suxing304/atrias/software/atrias/scripts/README

Scripts bag2mat.py and load_bag.py were copied from starmac_tools revision 293.
