suxing304/atrias/hardware/menial_board_v2.1/parts_list.xls

Quantity | Distributer | Distributer Part Number | Manufacturer Part Number | Ref. Des. | Description | Manufacturer
11 | Digikey | WM18920-ND | 353620250 | E-IN E-OUT LOGIC SW1-8 | CONN HEADER 2POS 2MM VERT TIN | MOLEX INC
3 | Digikey | WM18922-ND | 353620450 | AUX1-3 | CONN HEADER 4POS 2MM VERT TIN | MOLEX INC
2 | Digikey | WM18923-ND | 353620550 | HALL RGB_LED | CONN HEADER 5POS 2MM VERT TIN | MOLEX INC
3 | Digikey | WM18924-ND | 353620650 | SSI_BISS1-3 | CONN HEADER 6POS 2MM VERT TIN | MOLEX INC
3 | Digikey | WM18926-ND | 353620850 | INC_ENCODER STRAIN THERMISTOR | CONN HEADER 8POS 2MM VERT TIN | MOLEX INC
1 | Digikey | WM18586-ND | 87831-2220 | AMP_CONN | CONN HEADER 22POS 2MM VERT GOLD | MOLEX CONNECTOR CORPORATION
1 | Digikey | SW1015-ND | A6S-6104-H | DIP_SWITCH | SWITCH DIP 6POS TOP ACT GULLEAD | OMRON ELECTRONICS INC-EMC DIV
2 | Digikey | ADG3308BRUZ-ND | ADG3308BRUZ | U7 U12 | IC XLATOR 8CH 1.2-5.5V 20-TSSOP | ANALOG DEVICES INC
3 | Digikey | ADM3490ARZ-ND | ADM3490ARZ | U3-5 | IC TXRX RS-422/485 3.3V 8-SOIC | ANALOG DEVICES INC
1 | Digikey | ADN4668ARUZ-ND | ADN4668ARUZ | U6 | IC RCVR LVDS DIFF 4CH 16TSSOP | ANALOG DEVICES INC
12 | Digikey | 399-1100-1-ND | C0603C104Z3VACTU | C7-12 C17-19 C25-27 | CAP CER 0.1UF 25V Y5V 0603 | KEMET (VA)
6 | Digikey | 445-5062-1-ND | C1608C0G1H131J | C1-6 | CAP CER 130PF 50V 5% NP0 0603 | TDK CORPORATION (VA)
2 | Digikey | 445-5051-1-ND | C1608C0G1H160J | C15-16 | CAP CER 16PF 50V 5% NP0 0603 | TDK CORPORATION (VA)
2 | Digikey | 445-1313-1-ND | C1608X7R1H473K080AA | C22-23 | CAP CER 0.047UF 50V 10% X7R 0603 | TDK CORPORATION (VA)
1 | Digikey | P5850-ND | ECA-2AHG471 | C24 | CAP ALUM 470UF 100V 20% RADIAL | PANASONIC ELECTRONIC COMPONENTS
3 | Digikey | Z2101-ND | G3VM-61D1 | U1-2 U8 | RELAY SSR SPST 60V 500MA 4SMT | OMRON ELECTRONICS INC-EMC DIV
1 | Digikey | 390-1125-5-ND | IL3122-3E | U10 | TXRX ISO BUS 5MBPS RS422 16SOIC | NVE CORP/ISOLATION PRODUCTS
1 | Digikey | ED1762-ND | EDZ1110/5 | MOTOR_POWER | TERM BLOCK PLUG 5.08MM 5POS | ON SHORE TECHNOLOGY INC
1 | Digikey | ED2846-ND | OSTOQ055450 | MOTOR_POWER | TERM BLOCK HDR 5.08MM 5POS PCB | ON SHORE TECHNOLOGY INC
2 | Digikey | P10GCT-ND | ERJ-3GEYJ100V | R22-23 | RES 10 OHM 1/10W 5% 0603 SMD | PANASONIC ELECTRONIC COMPONENTS (VA)
3 | Digikey | P10KGCT-ND | ERJ-3GEYJ103V | R9-11 R32 | RES 10K OHM 1/10W 5% 0603 SMD | PANASONIC ELECTRONIC COMPONENTS (VA)
1 | Digikey | P143KHCT-ND | ERJ-3EKF1433V | R26 | RES 143K OHM 1/10W 1% 0603 SMD | PANASONIC ELECTRONIC COMPONENTS (VA)
5 | Digikey | P20KGCT-ND | ERJ-3GEYJ203V | R1-2 R12-14 R28 | RES 20K OHM 1/10W 5% 0603 SMD | PANASONIC ELECTRONIC COMPONENTS (VA)
8 | Digikey | P249HCT-ND | ERJ-3EKF2490V | R7-8 R15-20 | RES 249 OHM 1/10W 1% 0603 SMD | PANASONIC ELECTRONIC COMPONENTS (VA)
1 | Digikey | P3.74KHCT-ND | ERJ-3EKF3741V | R30 | RES 3.74K OHM 1/10W 1% 0603 SMD | PANASONIC ELECTRONIC COMPONENTS (VA)
10 | Digikey | P4.7KGCT-ND | ERJ-3GEYJ472V | R24-25 R40-47 | RES 4.7K OHM 1/10W 5% 0603 SMD | PANASONIC ELECTRONIC COMPONENTS (VA)
2 | Digikey | P510GCT-ND | ERJ-3GEYJ511V | R34 R36-37 R39 | RES 510 OHM 1/10W 5% 0603 SMD | PANASONIC ELECTRONIC COMPONENTS (VA)
3 | Digikey | P5.1KGCT-ND | ERJ-3GEYJ512V | R27 R29 | RES 5.1K OHM 1/10W 5% 0603 SMD | PANASONIC ELECTRONIC COMPONENTS (VA)
1 | Digikey | P68GCT-ND | ERJ-3GEYJ680V | R21 | RES 68 OHM 1/10W 5% 0603 SMD | PANASONIC ELECTRONIC COMPONENTS (VA)
2 | Digikey | P680GCT-ND | ERJ-3GEYJ681V | R31 R33 | RES 680 OHM 1/10W 5% 0603 SMD | PANASONIC ELECTRONIC COMPONENTS (VA)
2 | Digikey | P820GCT-ND | ERJ-3GEYJ821V | R35 R38 | RES 820 OHM 1/10W 5% 0603 SMD | PANASONIC ELECTRONIC COMPONENTS (VA)
1 | Digikey | 296-26358-1-ND | SN65LVDS049PWR | U13 | IC LVDS DUAL DIF DVR/RCV 16TSSOP | TEXAS INSTRUMENTS (VA)
1 | Digikey | P24.9KHCT-ND | ERJ-3EKF2492V |  | RES 24.9K OHM 1/10W 1% 0603 SMD | PANASONIC ELECTRONIC COMPONENTS (VA)
1 | Digikey | WM18051-ND | 51110-2251 | AMP_CONN | CONN HOUSING 2MM 22POS POLARIZED | MOLEX CONNECTOR CORPORATION
22 | Digikey | WM1128CT-ND | 503948051 | AMP_CONN | CONN TERM FEMALE 24-30AWG GOLD | MOLEX INC (VA)
11 | Digikey | WM5981-ND | 355070200 | E-IN E-OUT LOGIC SW1-8 | CONN RECEPTACLE HOUSING 2POS 2MM | MOLEX INC
3 | Digikey | WM5983-ND | 355070400 | AUX1-3 | CONN RECEPTACLE HOUSING 4POS 2MM | MOLEX INC
2 | Digikey | WM5984-ND | 35507-0500 | HALL RGB_LED | CONN RECEPTACLE HOUSING 5POS 2MM | MOLEX CONNECTOR CORPORATION
3 | Digikey | WM5985-ND | 355070600 | SSI_BISS1-3 | CONN RECEPTACLE HOUSING 6POS 2MM | MOLEX INC
3 | Digikey | WM5987-ND | 355070800 | INC_ENCODER STRAIN THERMISTOR | CONN RECEPTACLE HOUSING 8POS 2MM | MOLEX INC
86 | Digikey | WM6050-ND | 502128100 |  | CONN TERM FEMALE 24-30AWG TIN | MOLEX INC
2 | Samtec | SSM-112-L-DV-BE | SSM-112-L-DV-BE | DZRALTE_CONN | .100" (2,54 mm) Tiger Claw™ Surface Mount Socket Strip | Samtec
1 | Samtec | SSM-115-L-DV-BE | SSM-115-L-DV-BE | DZRALTE_CONN | .100" (2,54 mm) Tiger Claw™ Surface Mount Socket Strip | Samtec
