suxing304/atrias/hardware/amp_breakout_v1/BOM.ods

Quantity: | Reference ID: | Digikey Part:
1 | J2 | WM18586-ND
1 | C24 | P5850-ND
1 | J3 | ED2831-ND
1 | J3 | ED2869-ND
2 | R1-2 | P20KGCT-ND
2 | J1 | SAM1146-12-ND
1 | J1 | SAM1146-15-ND
