suxing304/atrias/documentation/ATRIAS_2.0_Amp_Stack.DXF

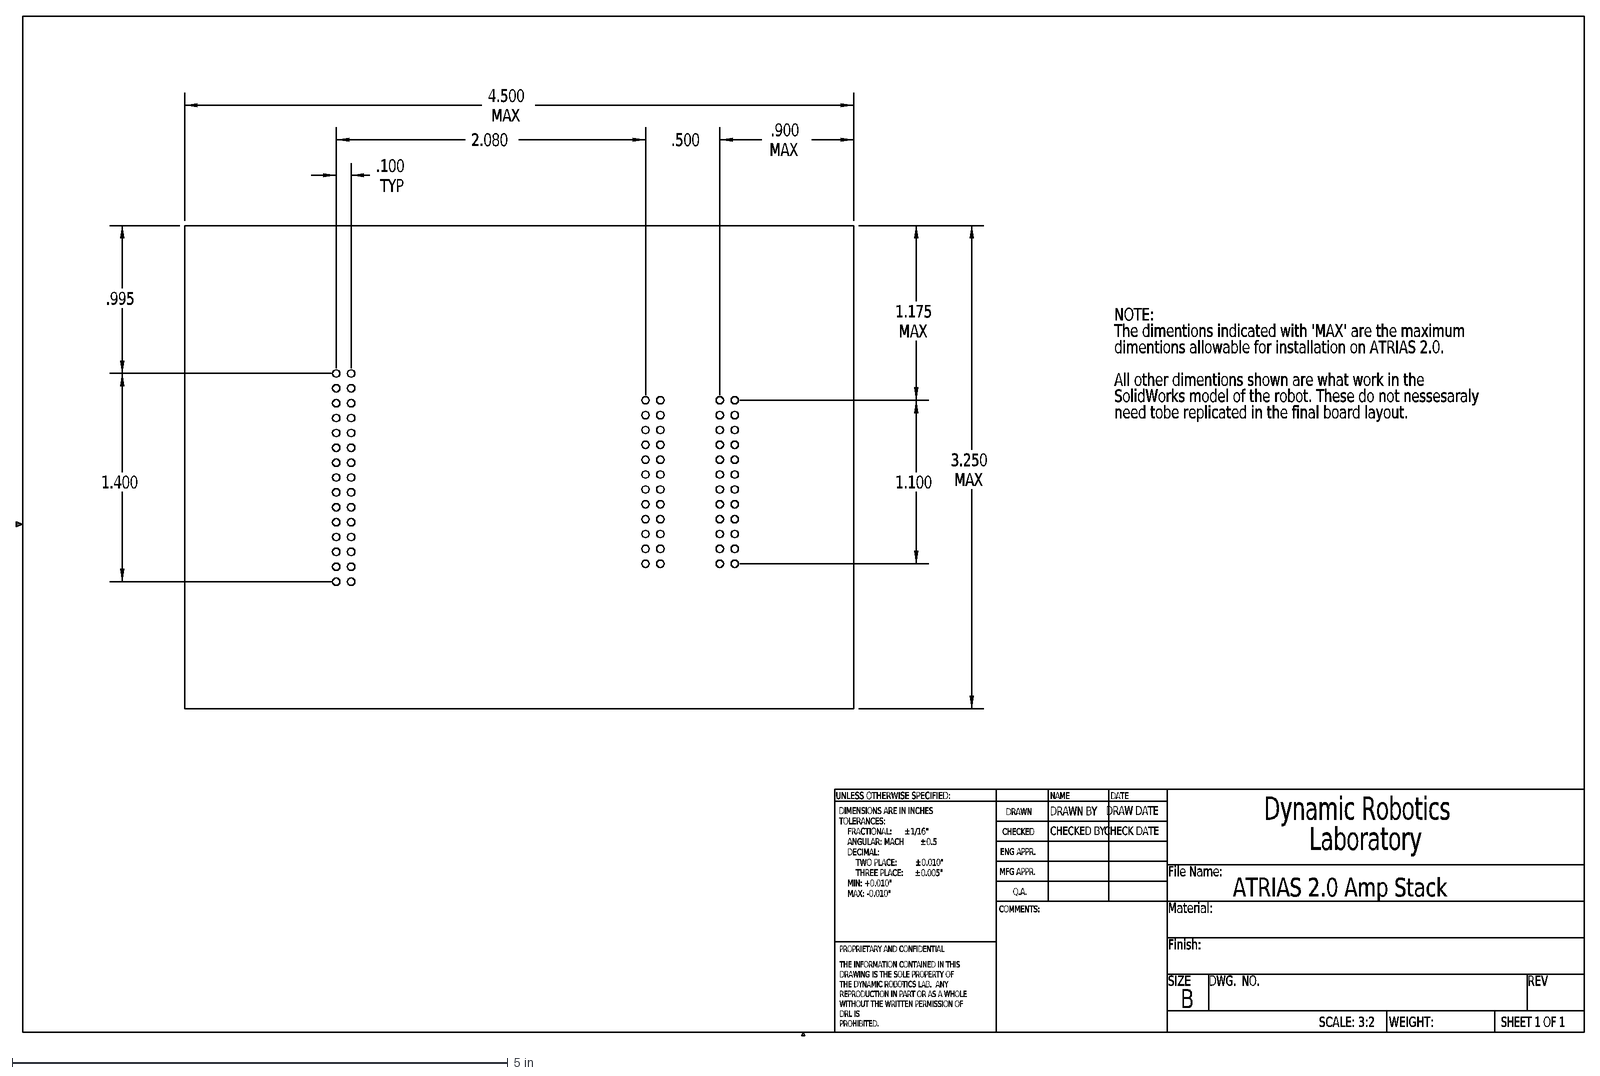
[picture p1: CAD file, 2012-02-10]
documentation/ATRIAS_2.0_Amp_Stack.DXF
NOTE:
The dimentions indicated with 'MAX' are the maximum
dimentions allowable for installation on ATRIAS 2.0.
All other dimentions shown are what work in the
SolidWorks model of the robot. These do not nessesaraly
need tobe replicated in the final board layout.
THE INFORMATION CONTAINED IN THIS
DRAWING IS THE SOLE PROPERTY OF
THE DYNAMIC ROBOTICS LAB. ANY
REPRODUCTION IN PART OR AS A WHOLE
WITHOUT THE WRITTEN PERMISSION OF
DRL IS
PROHIBITED.
PROPRIETARY AND CONFIDENTIAL
DIMENSIONS ARE IN INCHES
TOLERANCES:
FRACTIONAL:
±
1/16"
ANGULAR: MACH
0.5
DECIMAL:
TWO PLACE:
0.010"
THREE PLACE:
0.005"
MIN: +0.010"
MAX: -0.010"
DRAWN
CHECKED
ENG APPR.
MFG APPR.
Q.A.
COMMENTS:
DATE
NAME
SIZE
B
DWG. NO.
REV
WEIGHT:
UNLESS OTHERWISE SPECIFIED:
SHEET 1 OF 1
Material:
ATRIAS 2.0 Amp Stack
Finish:
DRAWN BY
DRAW DATE
SCALE: 3:2
File Name:
CHECKED BY
CHECK DATE
Dynamic Robotics
Laboratory
4.500
MAX
2.080
.500
.900
3.250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
