suxing304/atrias/hardware/strain_gauge_digitizer_v2.1/strain_gauge_digitizer_v2.1_sch.pdf

D

6 | 5 | 4 | 3 | 2 | 1

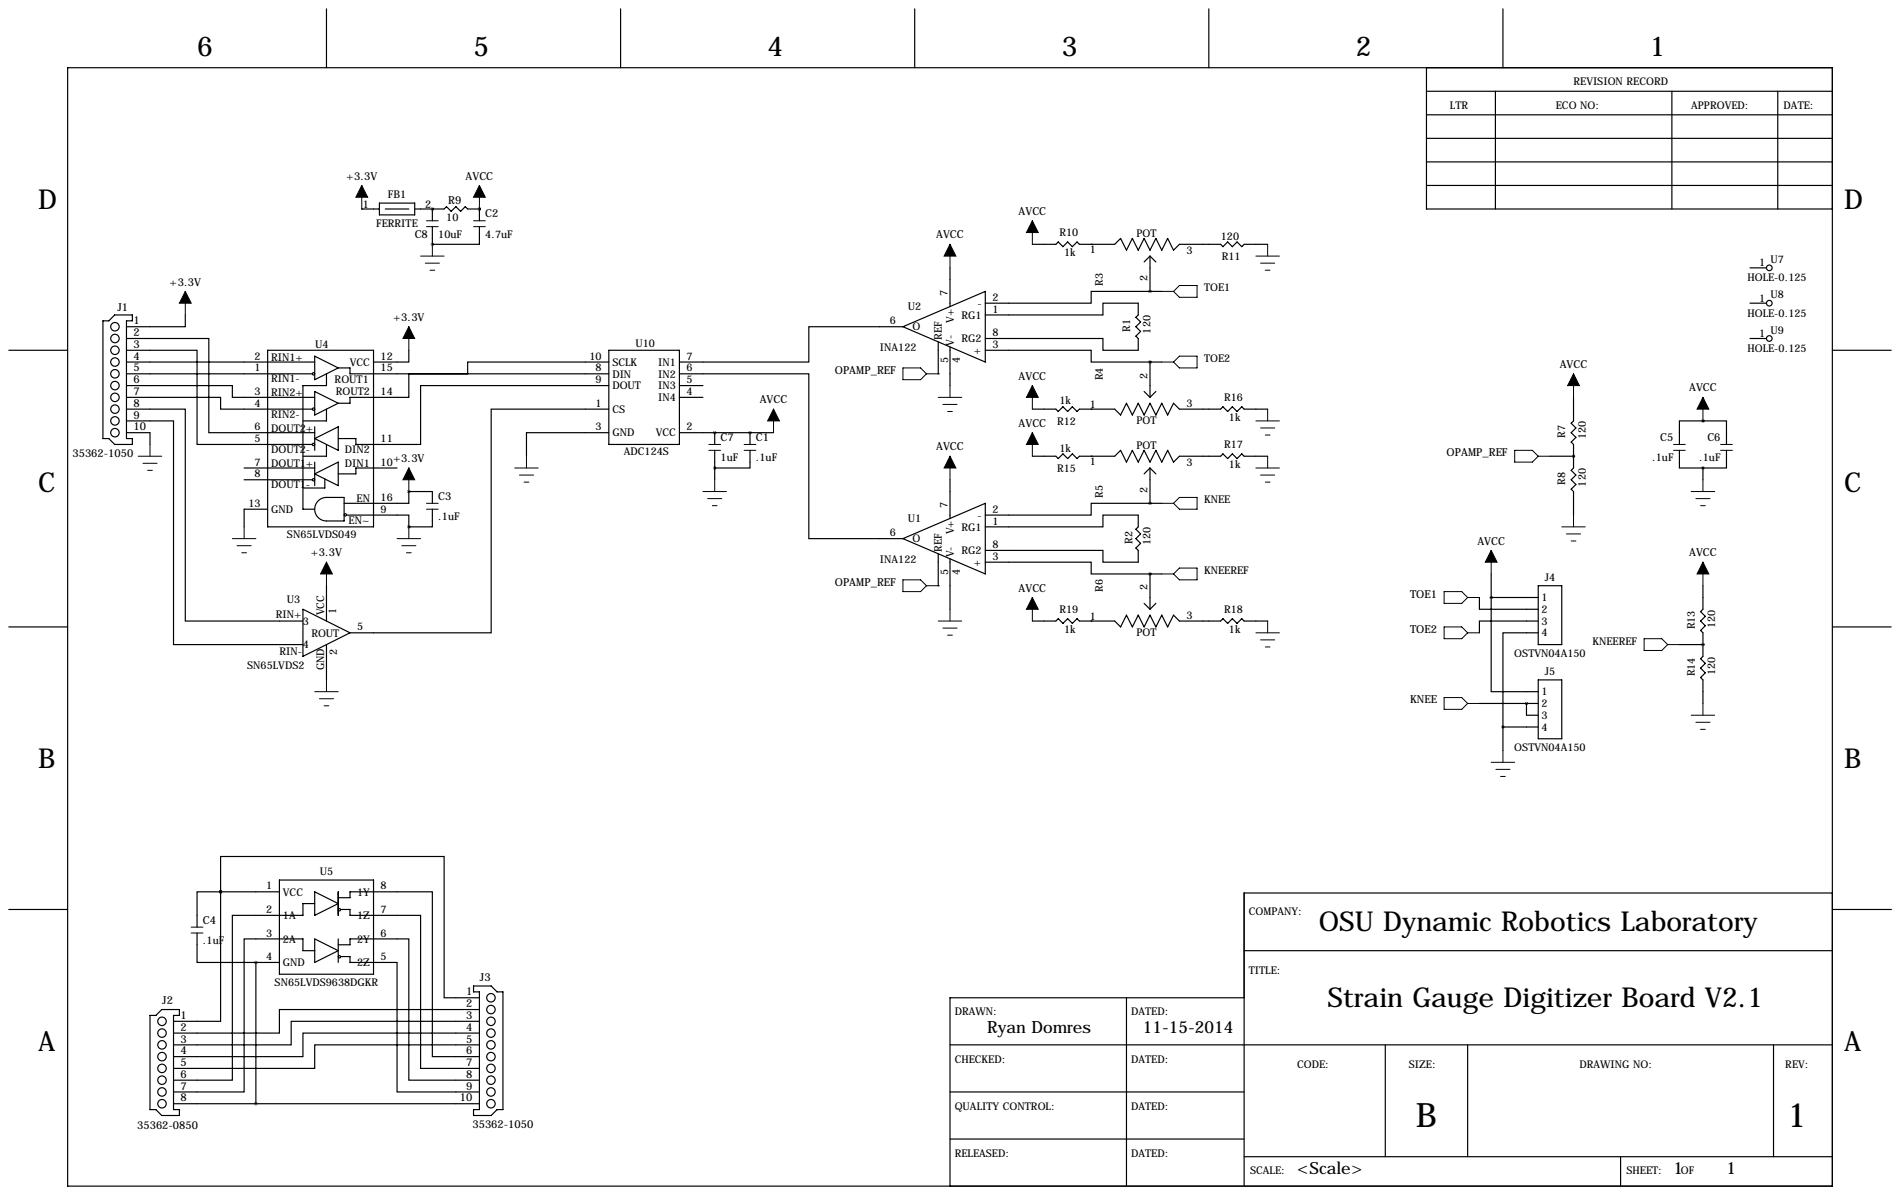
[picture p2: page 1]

+3.3V AVCC | REVISION RECORD

LTR | ECO NO: | APPROVED: | DATE:

COMPANY:
OSU Dynamic Robotics Laboratory

Strain Gauge Digitizer Board V2.1

RELEASED: | DATED:

<Scale> SCALE: | 1 1 SHEET: OF
