suxing304/atrias/hardware/amp_breakout_v1/amp_breakout_v1_sch.pdf

D

6 | 5 | 4 | 3 | 2 | 1

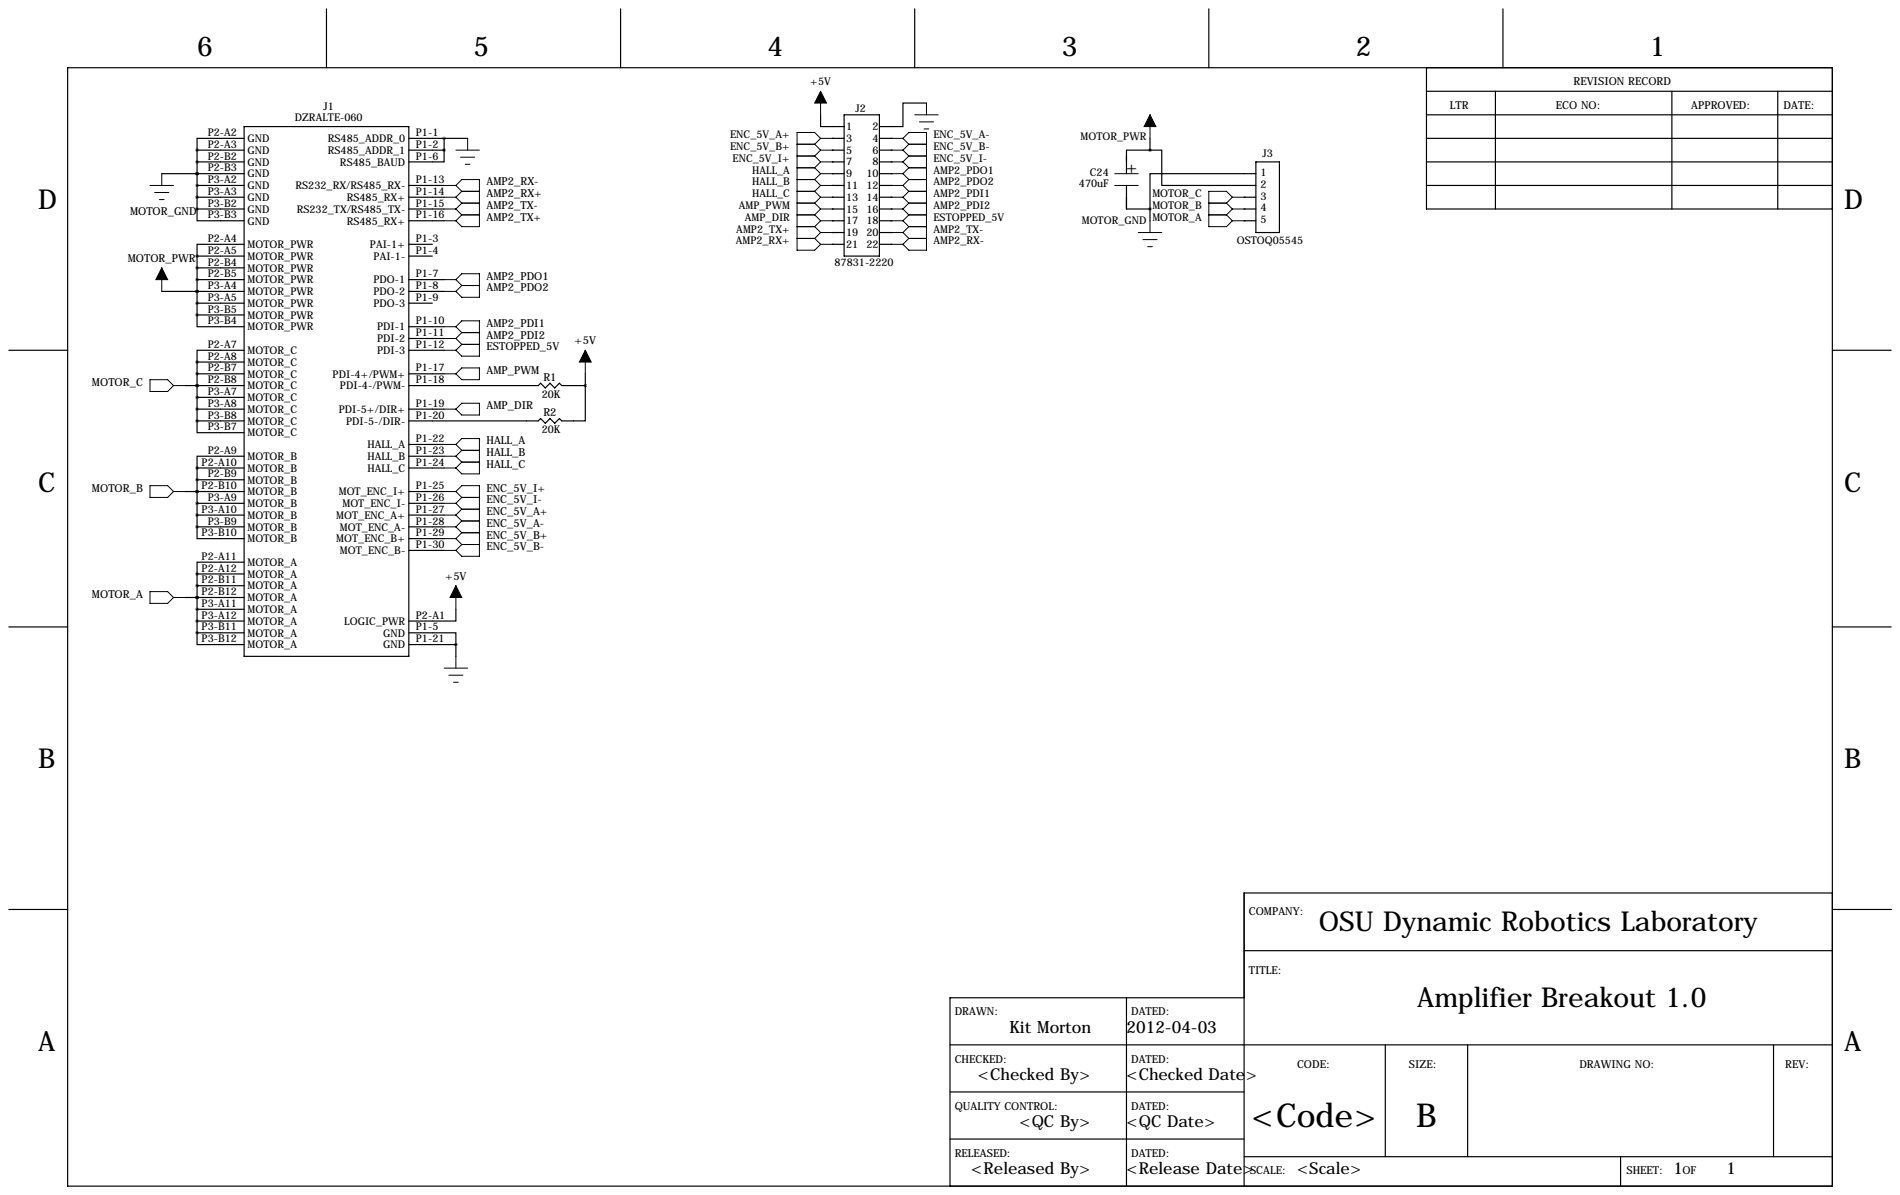
[picture p4: page 1]
Amplifier Breakout 1.0; <Release Date>; TITLE:; P1-1 RS485_ADDR_0; P1-2 RS485_ADDR_1; P1-3 PAI-1+; P1-4 PAI-1-; P1-5 GND; P1-6 RS485_BAUD; P1-7 PDO-1; P1-8 PDO-2; P1-9 PDO-3; P1-10 PDI-1; P1-11 PDI-2; P1-12 PDI-3; P1-17 PDI-4+/PWM+; P1-18 PDI-4-/PWM-; P1-19 PDI-5+/DIR+; P1-20 PDI-5-/DIR-; P1-21 GND; P1-22 HALL_A; P1-23 HALL_B; P1-24 HALL_C; P1-25 MOT_ENC_I+; P1-26 MOT_ENC_I-; P1-27 MOT_ENC_A+; P1-28 MOT_ENC_A-; P1-29 MOT_ENC_B+; P1-30 MOT_ENC_B-; P2-A1 LOGIC_PWR; GND P2-A3; GND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

+5V | REVISION RECORD

LTR | ECO NO: | APPROVED: | DATE:

COMPANY:
OSU Dynamic Robotics Laboratory

DRAWN: Kit Morton | DATED: 2012-04-03

CHECKED: <Checked By> | DATED: <Checked Date> | CODE: <Code> | SIZE: B | DRAWING NO: | REV:

QUALITY CONTROL: <QC By> | DATED: <QC Date>

RELEASED: <Released By> | DATED:

<Scale> SCALE: | 1 1 SHEET: OF
