suxing304/atrias/hardware/encoder_differential_driver_v1/encoder_differential_driver_v1_sch.pdf

D

6 | 5 | 4 | 3 | 2 | 1

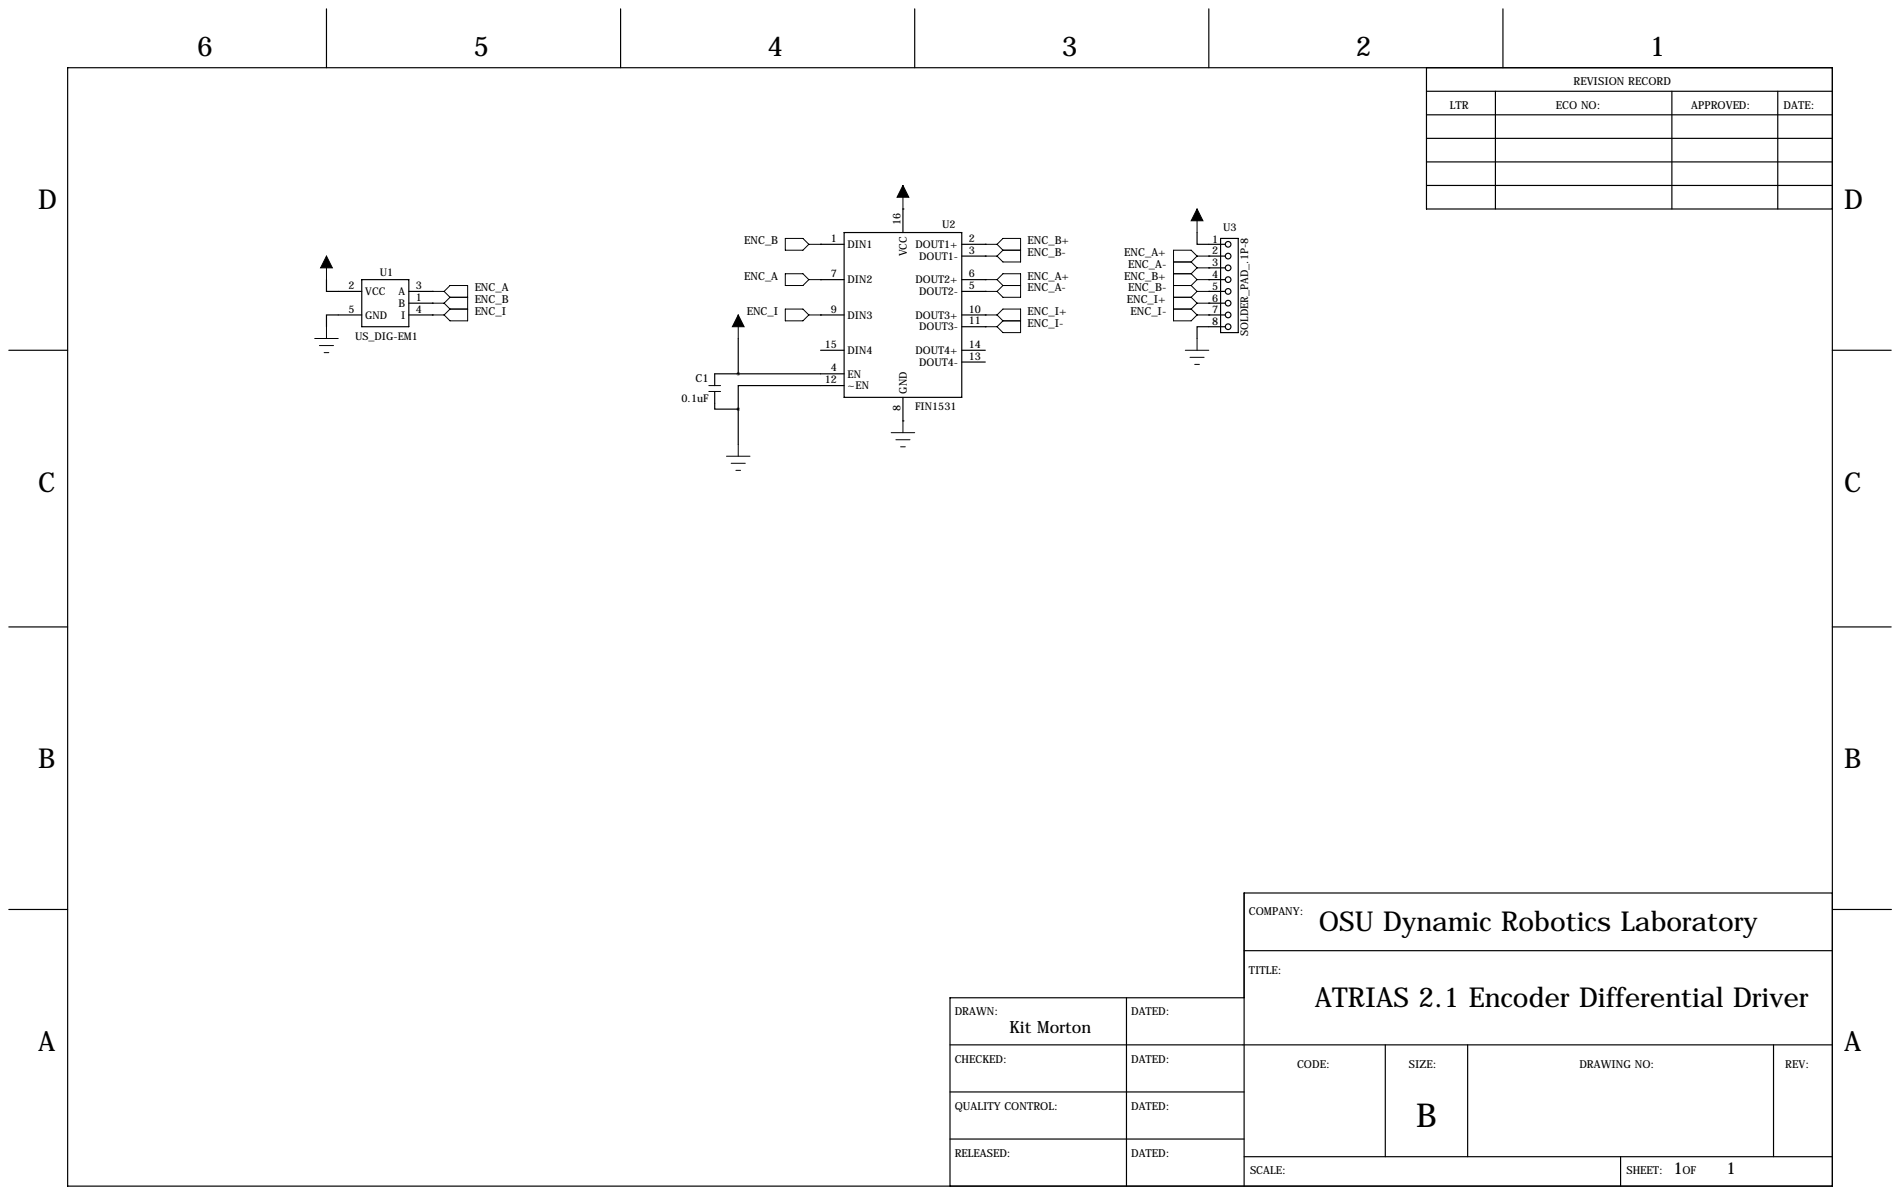
[picture p5: page 1]
VCC; GND; US_DIG-EM1; DIN1; DIN2; DIN3; DIN4; DOUT1+; DOUT1-; DOUT2+; DOUT2-; 10 DOUT3+; 11 DOUT3-; 14 DOUT4+; 13 DOUT4- 4; 16 VCC; 8 GND; FIN1531; SOLDER_PAD_.1P-8; ENC_A ENC_B ENC_I; ENC_B; ENC_A; ENC_I; ENC_B+ ENC_B-; ENC_A+ ENC_A-; ENC_I+ ENC_I-; ENC_A+ ENC_A- ENC_B+ ENC_B- ENC_I+ ENC_I-

REVISION RECORD

LTR | ECO NO: | APPROVED: | DATE:

COMPANY:
OSU Dynamic Robotics Laboratory

TITLE:
ATRIAS 2.1 Encoder Differential Driver

DRAWN: Kit Morton | DATED:
CHECKED: | DATED: | CODE: | SIZE: B | DRAWING NO: | REV:

QUALITY CONTROL: | DATED:

RELEASED: | DATED:

SCALE: | 1 1 SHEET: OF
