suxing304/atrias/hardware/menial_board_v2.1/menial_board_21_sch.pdf

D

6 | 5 | 4 | 3 | 2 | 1

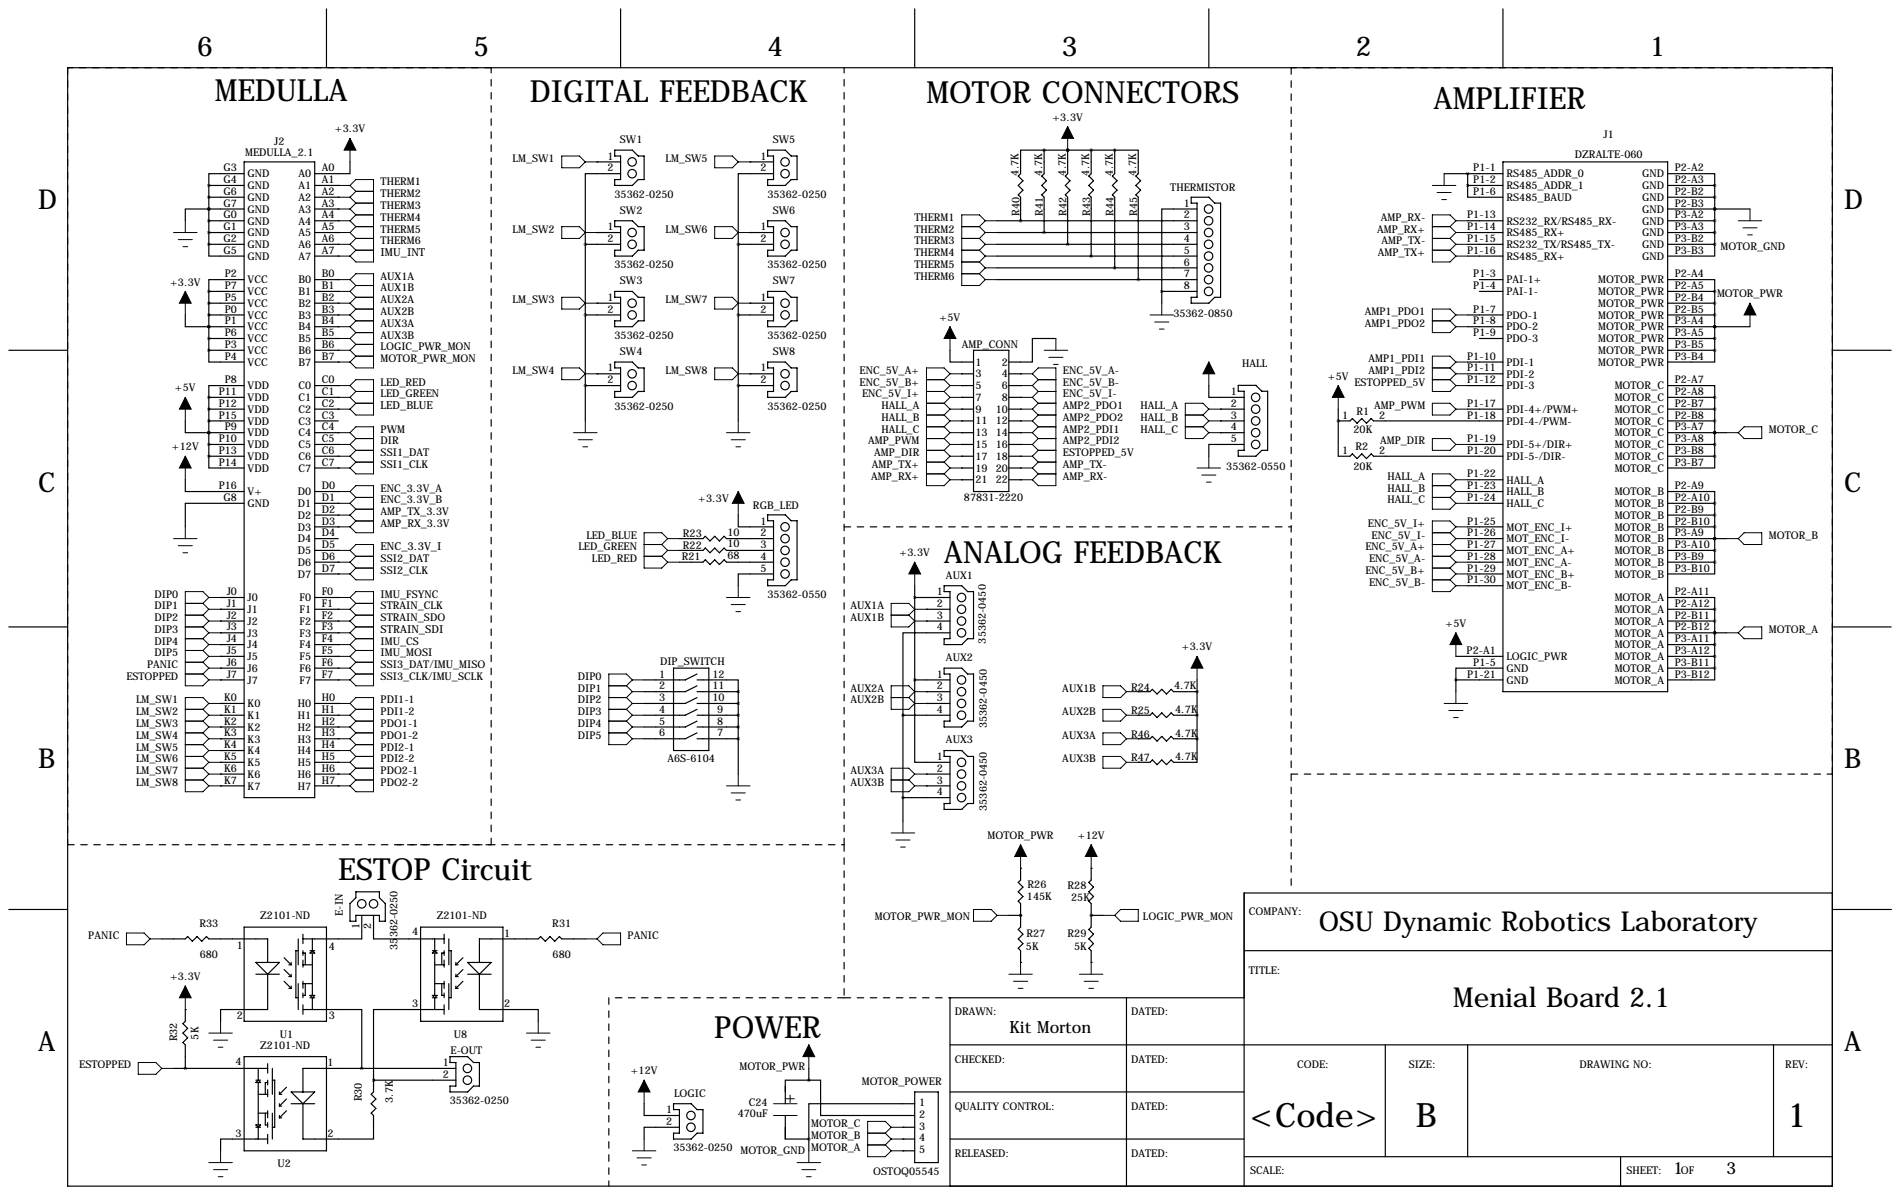
[picture p6: page 1]

COMPANY:
OSU Dynamic Robotics Laboratory

DRAWN: Kit Morton | DATED:

CHECKED: | DATED: | CODE: <Code> | SIZE: B | DRAWING NO: | REV: 1

RELEASED: | DATED:

SCALE: | SHEET: OF

D

D

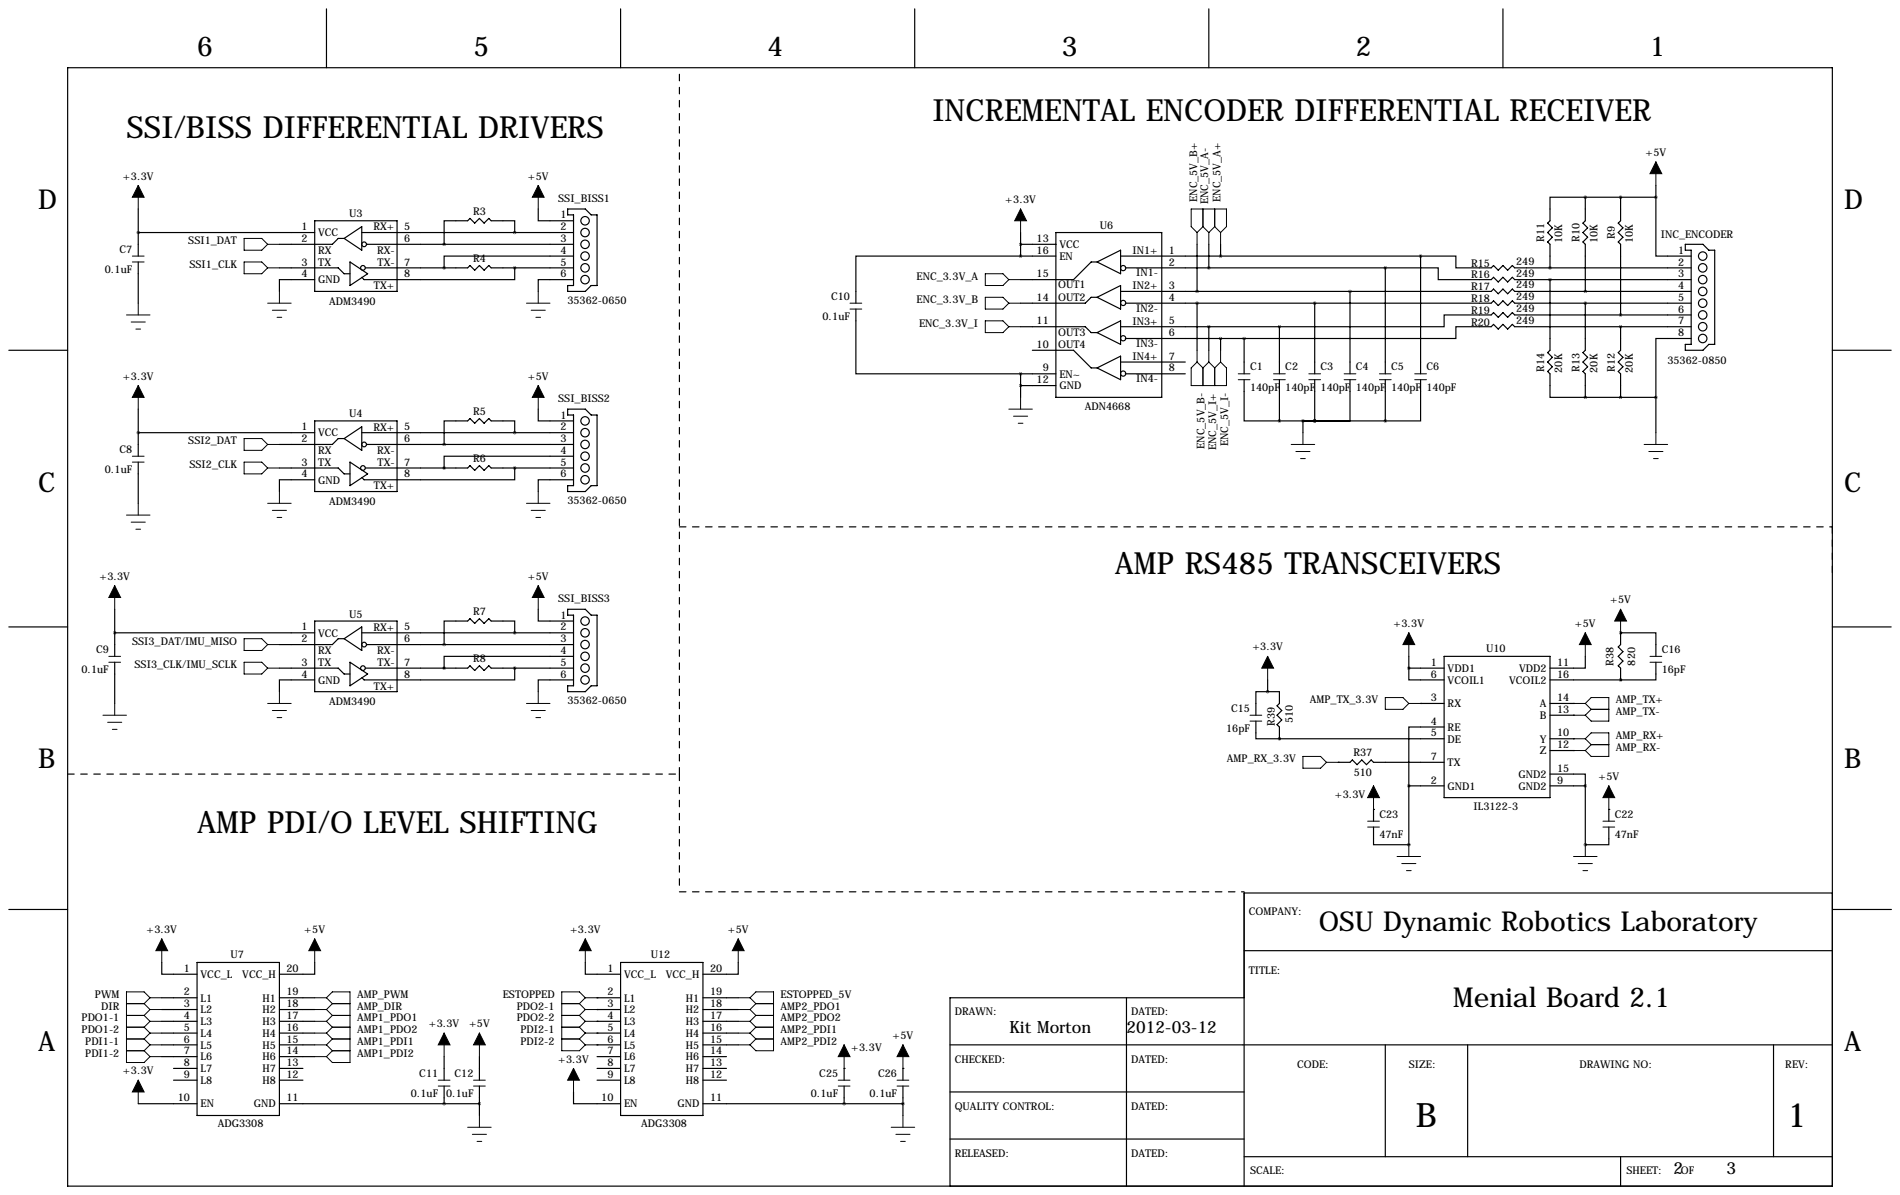
[picture p7: page 2]

AMP PDI/O LEVEL SHIFTING

COMPANY:
OSU Dynamic Robotics Laboratory

D

D

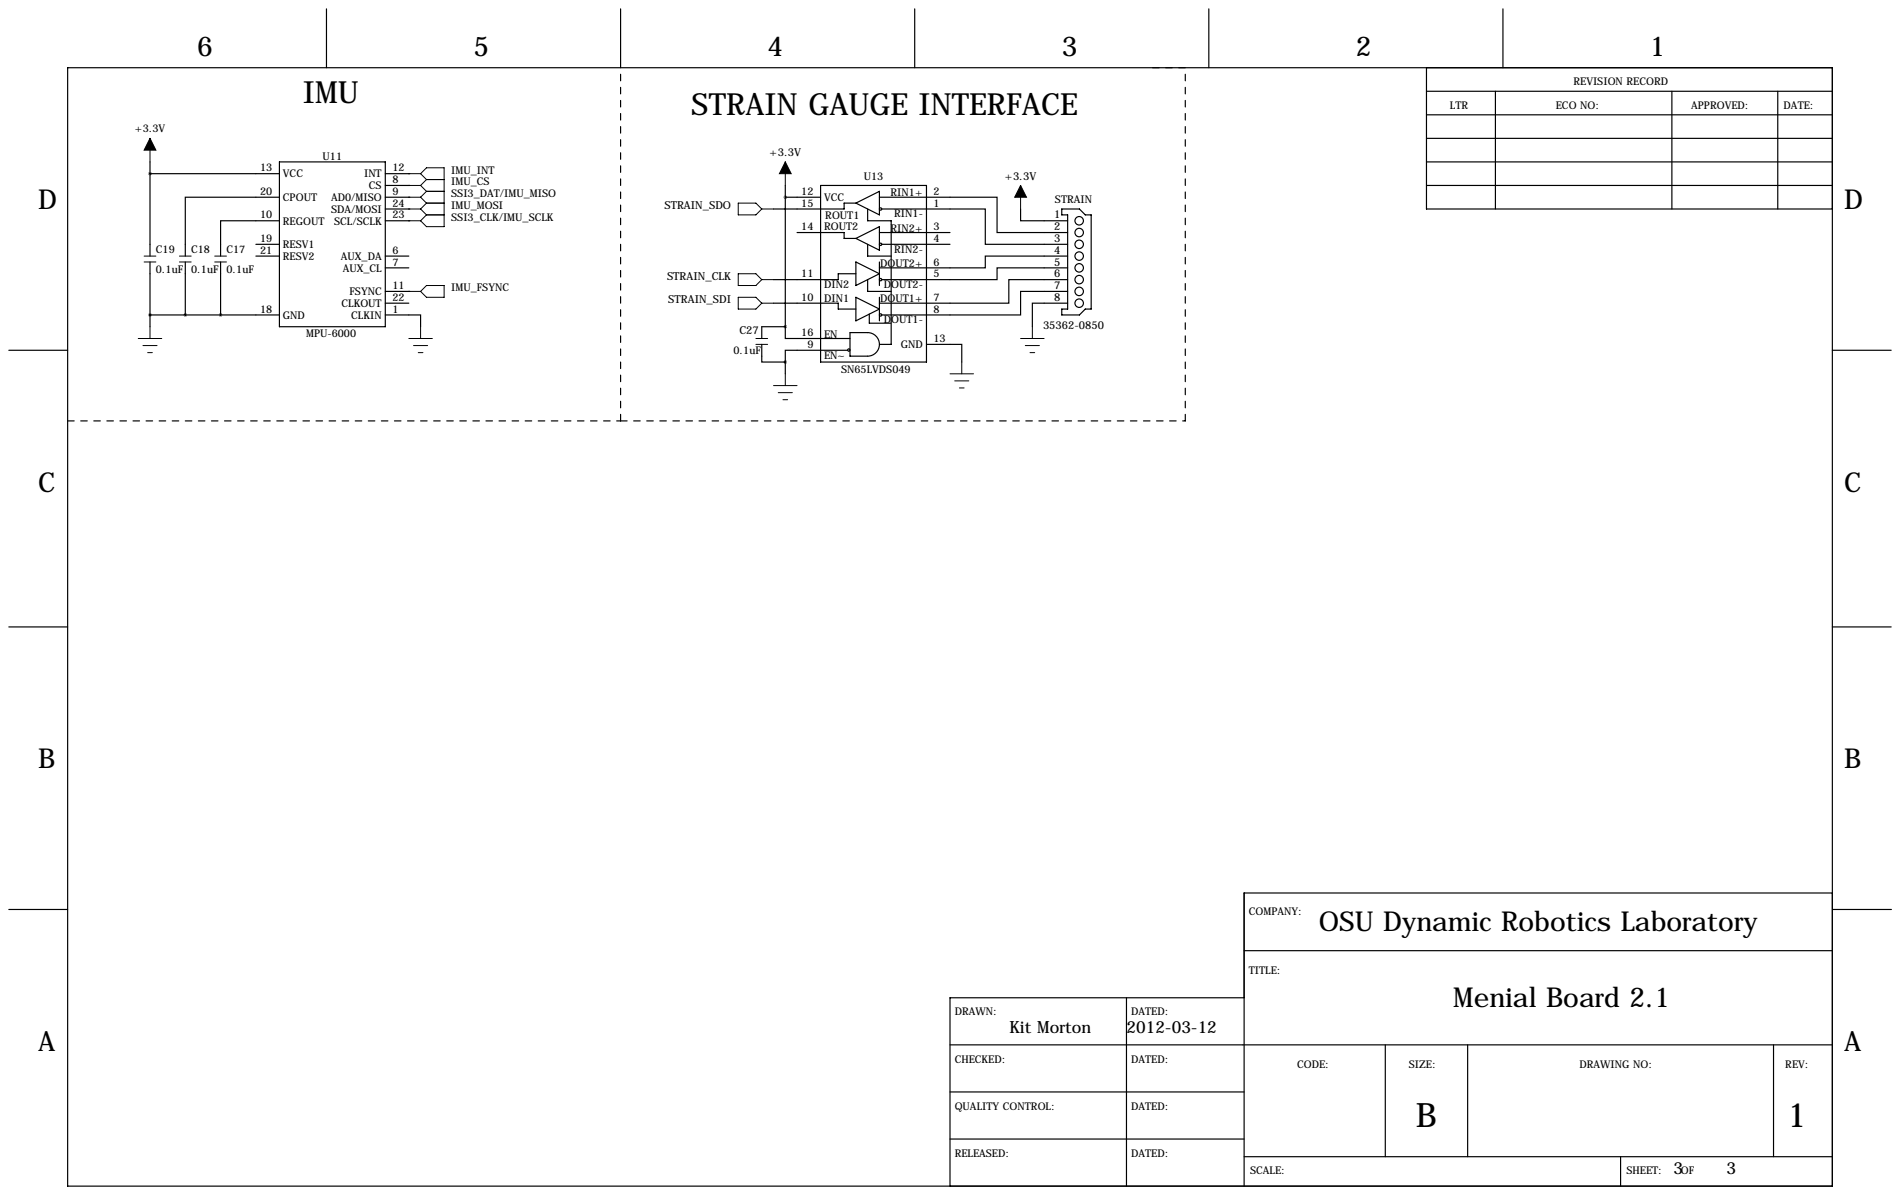
[picture p8: page 3]
Menial Board 2.1; TITLE:; VCC; CPOUT; REGOUT; RESV1 21; RESV2; GND; 12 INT; AD0/MISO; 24 SDA/MOSI; 23 SCL/SCLK; AUX_DA; AUX_CL; 11 FSYNC; 22 CLKOUT; CLKIN; MPU-6000; RIN1-; RIN1+; RIN2+; RIN2-; DOUT2-; DOUT2+; DOUT1+; DOUT1-; DIN1; DIN2; 13 GND; ROUT2; ROUT1; SN65LVDS049; STRAIN; IMU_INT IMU_CS SSI3_DAT/IMU_MISO IMU_MOSI SSI3_CLK/IMU_SCLK; IMU_FSYNC; STRAIN_SDI; STRAIN_CLK; STRAIN_SDO

IMU STRAIN GAUGE INTERFACE +3.3V | | REVISION RECORD

LTR | ECO NO: | APPROVED: | DATE:

COMPANY:
OSU Dynamic Robotics Laboratory

DRAWN: Kit Morton | DATED: 2012-03-12
CHECKED: | DATED: | CODE: | SIZE: B | DRAWING NO: | REV: 1

QUALITY CONTROL: | DATED:
