suxing304/atrias/hardware/strain_gauge_digitizer_v2.1/strain_gauge_digitizer_v2.1_pcb.pdf

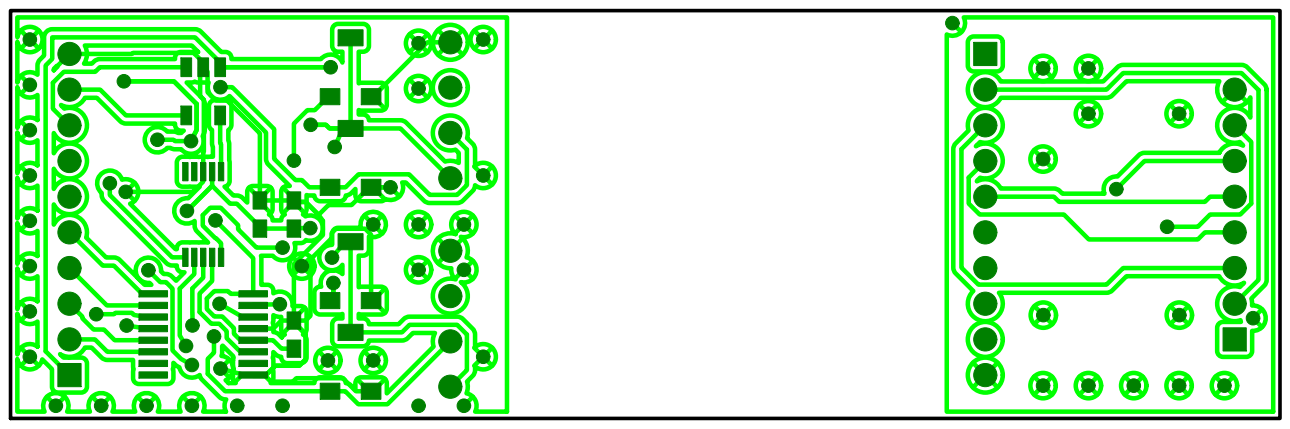
[picture p9: page 1]
U4U⁴x1 U⁴x2 U⁴x3 U⁴x4 U⁴x5 U⁴x6 U⁴x7 U⁴x8; U⁴x9 U⁴x10 U⁴x11 U⁴x12 U⁴x13 U⁴x14 U⁴x15 U⁴x16; U3U³x3 U³x2 U³x1 U³x4; U³x5; C1C¹x1 C¹x2; C3C³x1 C³x2; R4R⁴x1 R⁴x2; R⁴x3; R5R⁵x1 R⁵x2; R⁵x3; R6R⁶x1 R⁶x2; R⁶x3; C7C⁷x1 C⁷x2; U10 U¹⁰x5; U¹⁰x4; U¹⁰x3; U¹⁰x2; U¹⁰x1 U¹⁰x6; U¹⁰x7; U¹⁰x8; U¹⁰x9; U¹⁰x10

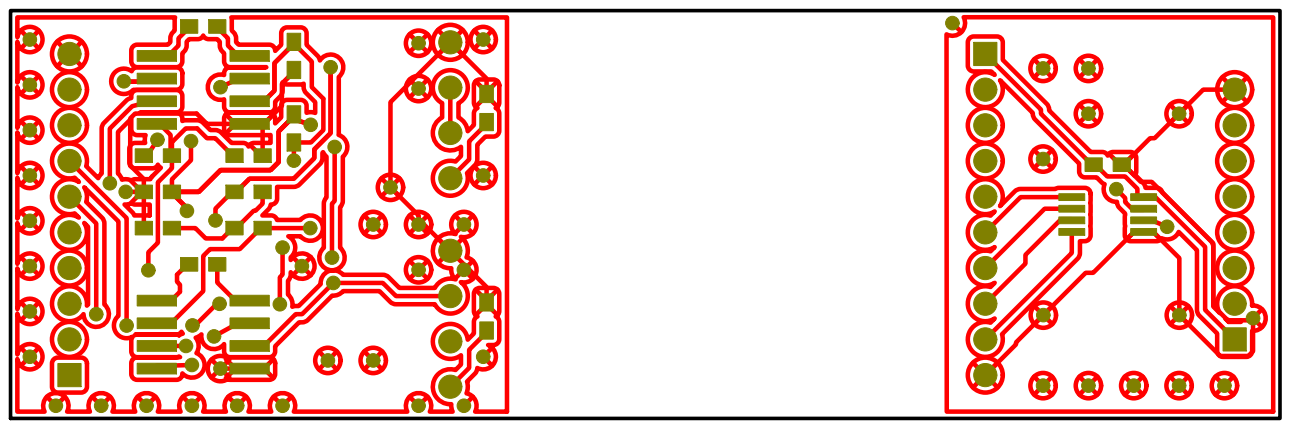
[picture p10: page 2]
U1U¹x1 U¹x2 U¹x3 U¹x5; U¹x4 U¹x6 U¹x7 U¹x8 U2U²x1 U²x2 U²x3 U²x5; U²x4 U²x6 U²x7 U²x8; R2R²x1; R²x2; R1R¹x1; R¹x2; U5U⁵x1 U⁵x2 U⁵x3 U⁵x5; U⁵x4 U⁵x6 U⁵x7; C2C²x2; C²x1; R7R⁷x2; R⁷x1; R8R⁸x2; R⁸x1; C5C⁵x1 C⁵x2; C6C⁶x1 C⁶x2; C4C⁴x1; C⁴x2; R13R¹³x1 R¹³x2; C8C⁸x2; C⁸x1; R9R⁹x1; R⁹x2; FB1 FB¹x1; FB¹x2; R14R¹⁴x1 R¹⁴x2

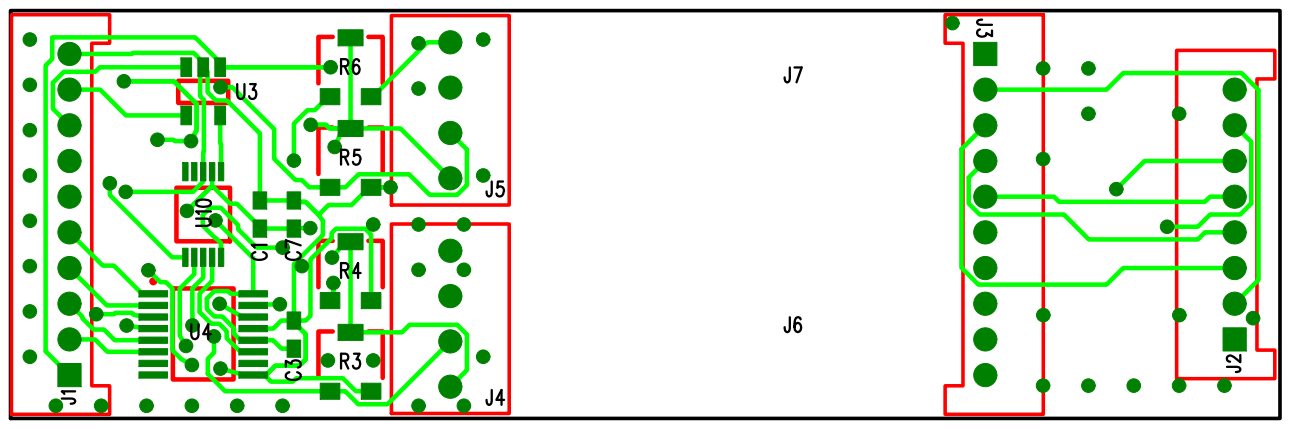
[picture p11: page 3]

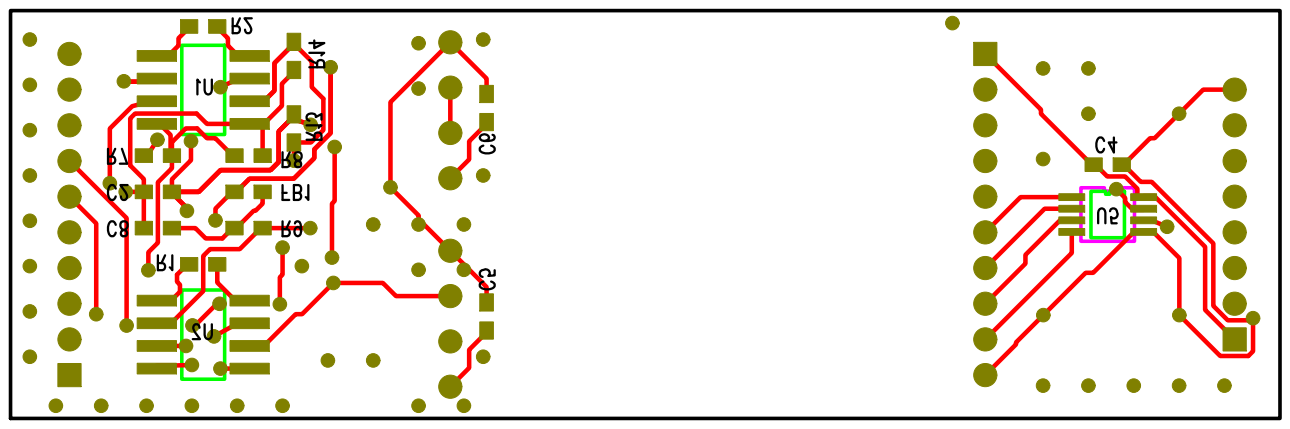
[picture p12: page 4]

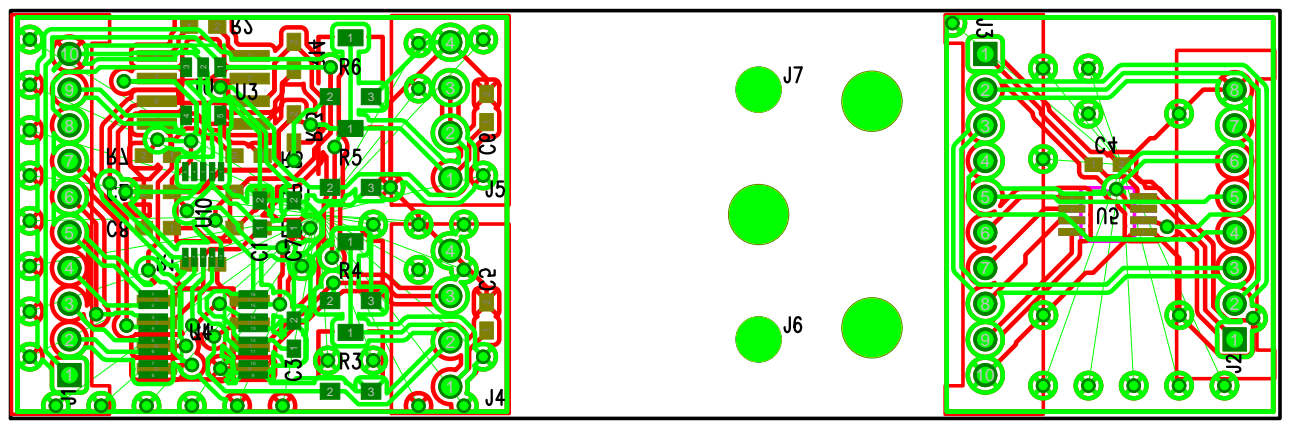
[picture p13: page 5]
