suxing304/atrias/hardware/ATRIAS_Power_Supply/ATRIAS_PowerSupply_schem.pdf

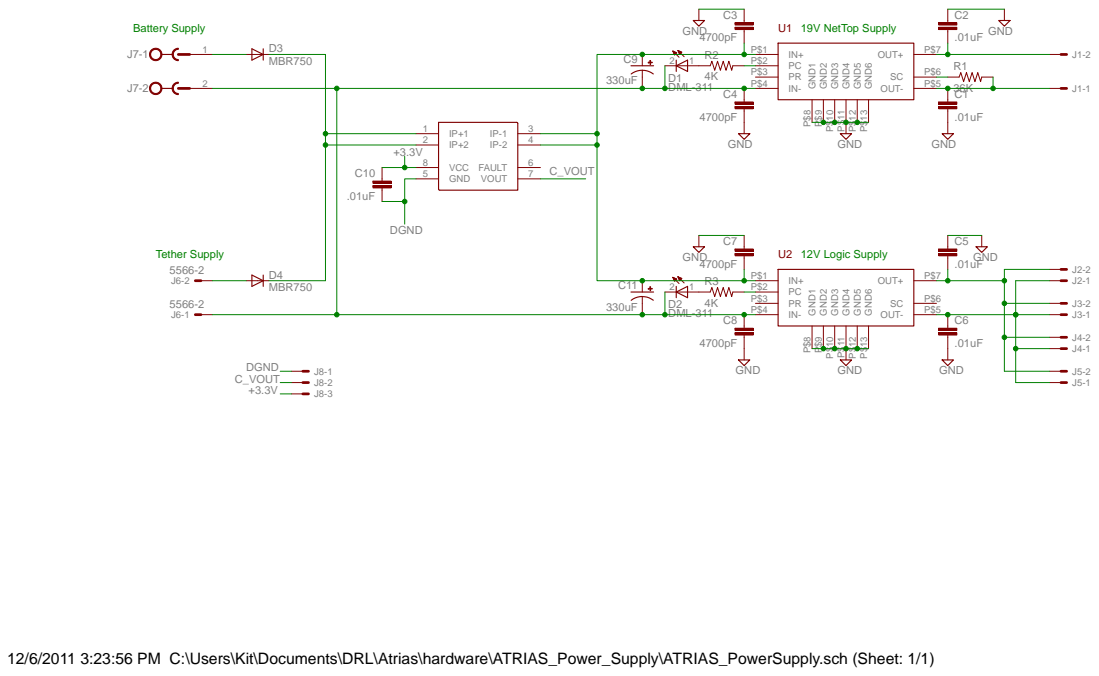
[picture p14: page 1]

12/6/2011 3:23:56 PM C:\Users\Kit\Documents\DRL\Atrias\hardware\ATRIAS_Power_Supply\ATRIAS_PowerSupply.sch (Sheet: 1/1)
