suxing304/atrias/documentation/ATRIAS_2.0_Amp_Stack.PDF

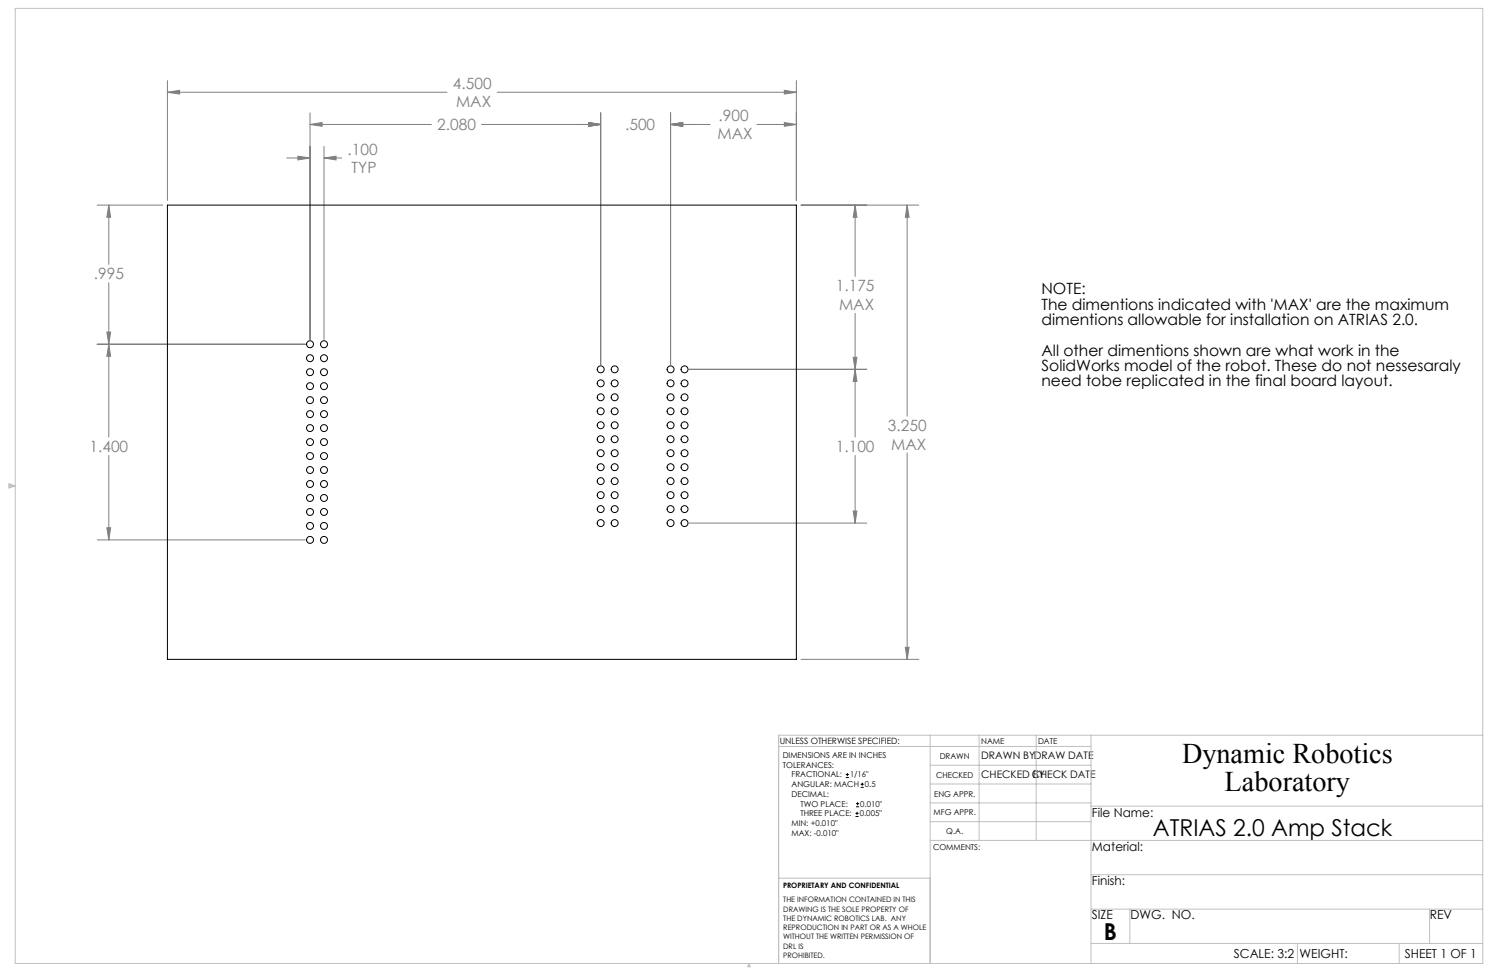
[picture p15: page 1]
ENG APPR.; MFG APPR.; DWG. NO.; REV; SHEET 1 OF 1; SCALE: 3:2; File Name:

NOTE:
The dimentions indicated with 'MAX' are the maximum
dimentions allowable for installation on ATRIAS 2.0.
All other dimentions shown are what work in the
SolidWorks model of the robot. These do not nessesaraly
need tobe replicated in the final board layout.

UNLESS OTHERWISE SPECIFIED:
DIMENSIONS ARE IN INCHES
TOLERANCES:
FRACTIONAL: 1/16"
ANGULAR: MACH 0.5
DECIMAL:
TWO PLACE: 0.010"
THREE PLACE: 0.005"
MIN: +0.010"
MAX: -0.010"

DRAWN BYDRAW DATE
CHECKED BYCHECK DATE

Dynamic Robotics
Laboratory
ATRIAS 2.0 Amp Stack

PROPRIETARY AND CONFIDENTIAL
THE INFORMATION CONTAINED IN THIS
DRAWING IS THE SOLE PROPERTY OF
THE DYNAMIC ROBOTICS LAB. ANY
REPRODUCTION IN PART OR AS A WHOLE
WITHOUT THE WRITTEN PERMISSION OF
DRL IS
PROHIBITED.
