suxing304/atrias/hardware/menial_board_v2/menial_board_v2-schematic.pdf

Stacking Board Connectors | Power

# Encoder Translation

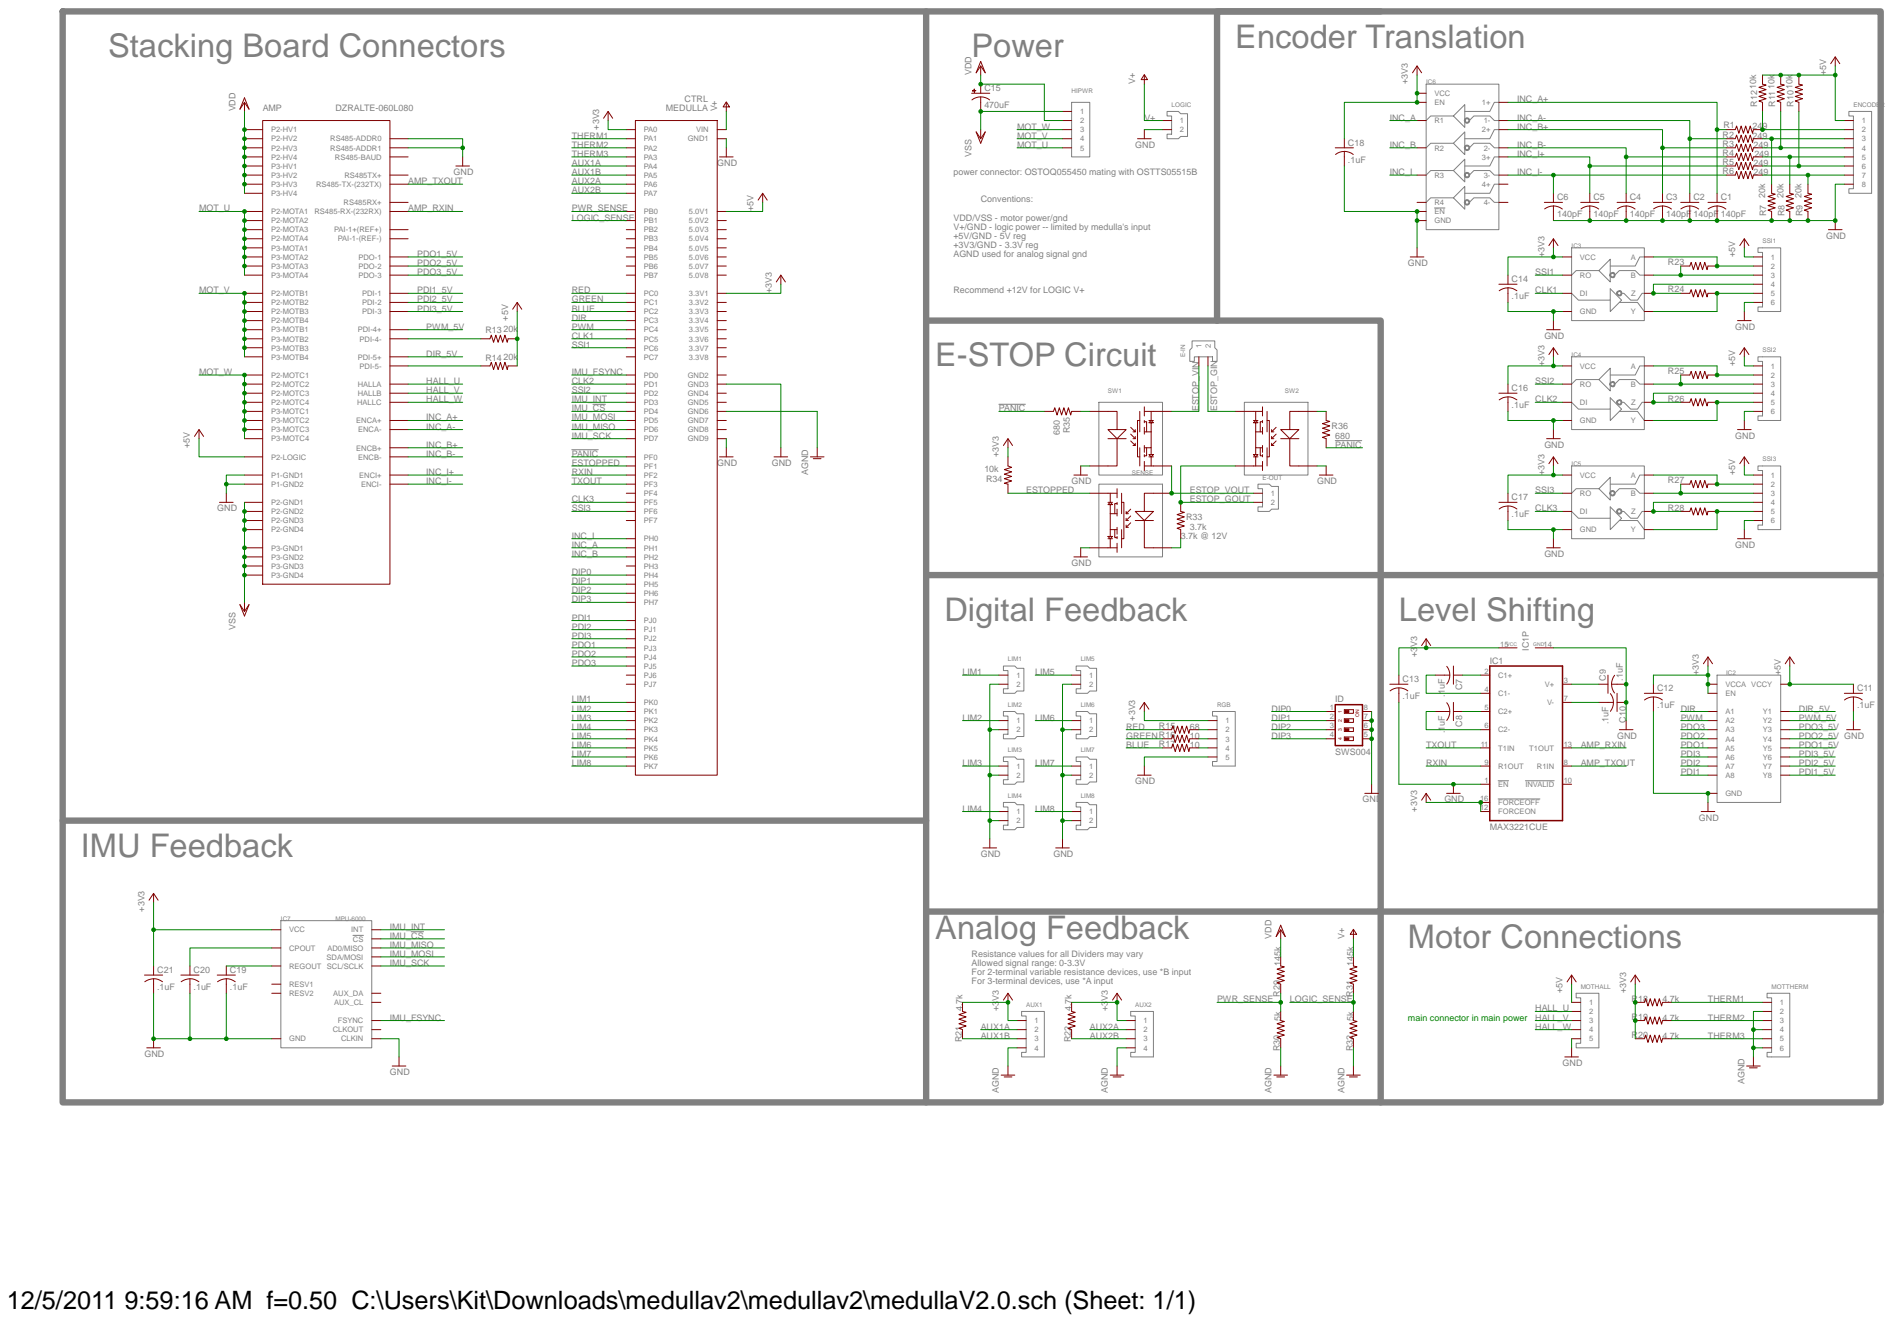
[picture p16: page 1]

power connector: OSTOQ055450 mating with OSTTS05515B

Conventions:
VDD/VSS - motor power/gnd
V+/GND - logic power -- limited by medulla's input
+5V/GND - 5V reg
+3V3/GND - 3.3V reg
AGND used for analog signal gnd

Resistance values for all Dividers may vary
Allowed signal range: 0-3.3V
For 2-terminal variable resistance devices, use *B input
For 3-terminal devices, use *A input

main connector in main power

12/5/2011 9:59:16 AM f=0.50 C:\Users\Kit\Downloads\medullav2\medullav2\medullaV2.0.sch (Sheet: 1/1)
