suxing304/atrias/hardware/menial_board_v2.1/strain_gauge_simulation.asc

C1: cap; 40pF
I1: current; 1nA
R1: res; {150-R1}; tol=0
R2: res; {150+R1}; tol=0
R3: res; 150; tol=0
R4: res; 150; tol=0
R5: res; 5K
R6: res; 120
R7: res; 120
U1: LT1789-1
V1: voltage; 3.3
Named nets: 0, Vo
.step param R1 -2 2 1
.op
