suxing304/atrias/(list of files, drawings)

Other design files:
hardware/amp_breakout_v1/amp_breakout_v1.pcb
hardware/ATRIAS_Power_Supply/Vicor_IAM.pcb
hardware/ATRIAS_Power_Supply/Vicor_LC_Filter.pcb
hardware/body_status_board_v1.1/body_status_board_v1_1.pcb
hardware/elmo_gold_drum_boards/elmo_gold_drum_port_c_v1.pcb
hardware/encoder_differential_driver_v1/encoder_differential_driver_v1.pcb
hardware/flat_flex_breakout_v1/flat_flex_sensors.pcb
hardware/flat_flex_breakout_v1/medulla_flat_flex.pcb
hardware/menial_board_v2.1/menial_board_21.pcb
hardware/strain_gauge_digitizer_v1/strain_gauge_digitizer_v1.pcb
hardware/strain_gauge_digitizer_v2.1/strain_gauge_digitizer_v2.1.pcb
hardware/strain_gauge_digitizer_v2/strain_gauge_digitizer_v2.pcb
hardware/xbee_interface/xbee_interface.pcb
