suxing304/atrias/robot_definitions/leg6_definitions.h

#ifndef LEG6_DEFINITIONS
#define LEG6_DEFINITIONS

/*------------------------------------------*/
/*------ Calibration Values for Leg 1 ------*/
/*------------------------------------------*/
#define LEG6_LEG_A_CALIB_VAL       264791392LL
#define LEG6_LEG_B_CALIB_VAL       265506465LL

#define LEG6_LEG_A_RAD_PER_CNT   9.8039216e-09
#define LEG6_LEG_B_RAD_PER_CNT  -9.8039216e-09

#define LEG6_TRAN_A_CALIB_VAL      199141730LL
#define LEG6_TRAN_B_CALIB_VAL      199584463LL

#define LEG6_TRAN_A_RAD_PER_CNT  9.8039216e-09
#define LEG6_TRAN_B_RAD_PER_CNT -9.8039216e-09

#define LEG6_MOTOR_A_DIRECTION            -1.0
#define LEG6_MOTOR_B_DIRECTION             1.0




// Ignore the lines below, they are used for the include magic.
#ifdef INCLUDE_LEFT_LEG
#define LEFT_LEG_A_CALIB_VAL     LEG6_LEG_A_CALIB_VAL
#define LEFT_LEG_B_CALIB_VAL     LEG6_LEG_B_CALIB_VAL

#define LEFT_LEG_A_RAD_PER_CNT   LEG6_LEG_A_RAD_PER_CNT
#define LEFT_LEG_B_RAD_PER_CNT   LEG6_LEG_B_RAD_PER_CNT

#define LEFT_TRAN_A_CALIB_VAL    LEG6_TRAN_A_CALIB_VAL
#define LEFT_TRAN_B_CALIB_VAL    LEG6_TRAN_B_CALIB_VAL 

#define LEFT_TRAN_A_RAD_PER_CNT  LEG6_TRAN_A_RAD_PER_CNT
#define LEFT_TRAN_B_RAD_PER_CNT  LEG6_TRAN_B_RAD_PER_CNT

#define LEFT_MOTOR_A_DIRECTION   LEG6_MOTOR_A_DIRECTION
#define LEFT_MOTOR_B_DIRECTION   LEG6_MOTOR_B_DIRECTION
#endif

#ifdef INCLUDE_RIGHT_LEG
#define RIGHT_LEG_A_CALIB_VAL    LEG6_LEG_A_CALIB_VAL
#define RIGHT_LEG_B_CALIB_VAL    LEG6_LEG_B_CALIB_VAL

#define RIGHT_LEG_A_RAD_PER_CNT  LEG6_LEG_A_RAD_PER_CNT
#define RIGHT_LEG_B_RAD_PER_CNT  LEG6_LEG_B_RAD_PER_CNT

#define RIGHT_TRAN_A_CALIB_VAL   LEG6_TRAN_A_CALIB_VAL
#define RIGHT_TRAN_B_CALIB_VAL   LEG6_TRAN_B_CALIB_VAL 

#define RIGHT_TRAN_A_RAD_PER_CNT LEG6_TRAN_A_RAD_PER_CNT
#define RIGHT_TRAN_B_RAD_PER_CNT LEG6_TRAN_B_RAD_PER_CNT

#define RIGHT_MOTOR_A_DIRECTION  LEG6_MOTOR_A_DIRECTION
#define RIGHT_MOTOR_B_DIRECTION  LEG6_MOTOR_B_DIRECTION
#endif

#endif //LEG6_DEFINITIONS
