suxing304/atrias/robot_definitions/leg1_definitions.h

#ifndef LEG1_DEFINITIONS
#define LEG1_DEFINITIONS

/*------------------------------------------*/
/*------ Calibration Values for Leg 1 ------*/
/*------------------------------------------*/
#define LEG1_LEG_A_CALIB_VAL       263824027LL
#define LEG1_LEG_B_CALIB_VAL       263616696LL

#define LEG1_LEG_A_RAD_PER_CNT   9.8039216e-09
#define LEG1_LEG_B_RAD_PER_CNT  -9.8039216e-09

#define LEG1_TRAN_A_CALIB_VAL      197682859LL
#define LEG1_TRAN_B_CALIB_VAL      198854199LL

#define LEG1_TRAN_A_RAD_PER_CNT  9.8039216e-09
#define LEG1_TRAN_B_RAD_PER_CNT -9.8039216e-09

#define LEG1_MOTOR_A_DIRECTION            -1.0
#define LEG1_MOTOR_B_DIRECTION             1.0




// Ignore the lines below, they are used for the include magic.
#ifdef INCLUDE_LEFT_LEG
#define LEFT_LEG_A_CALIB_VAL     LEG1_LEG_A_CALIB_VAL
#define LEFT_LEG_B_CALIB_VAL     LEG1_LEG_B_CALIB_VAL

#define LEFT_LEG_A_RAD_PER_CNT   LEG1_LEG_A_RAD_PER_CNT
#define LEFT_LEG_B_RAD_PER_CNT   LEG1_LEG_B_RAD_PER_CNT

#define LEFT_TRAN_A_CALIB_VAL    LEG1_TRAN_A_CALIB_VAL
#define LEFT_TRAN_B_CALIB_VAL    LEG1_TRAN_B_CALIB_VAL 

#define LEFT_TRAN_A_RAD_PER_CNT  LEG1_TRAN_A_RAD_PER_CNT
#define LEFT_TRAN_B_RAD_PER_CNT  LEG1_TRAN_B_RAD_PER_CNT

#define LEFT_MOTOR_A_DIRECTION   LEG1_MOTOR_A_DIRECTION
#define LEFT_MOTOR_B_DIRECTION   LEG1_MOTOR_B_DIRECTION
#endif

#ifdef INCLUDE_RIGHT_LEG
#define RIGHT_LEG_A_CALIB_VAL    LEG1_LEG_A_CALIB_VAL
#define RIGHT_LEG_B_CALIB_VAL    LEG1_LEG_B_CALIB_VAL

#define RIGHT_LEG_A_RAD_PER_CNT  LEG1_LEG_A_RAD_PER_CNT
#define RIGHT_LEG_B_RAD_PER_CNT  LEG1_LEG_B_RAD_PER_CNT

#define RIGHT_TRAN_A_CALIB_VAL   LEG1_TRAN_A_CALIB_VAL
#define RIGHT_TRAN_B_CALIB_VAL   LEG1_TRAN_B_CALIB_VAL 

#define RIGHT_TRAN_A_RAD_PER_CNT LEG1_TRAN_A_RAD_PER_CNT
#define RIGHT_TRAN_B_RAD_PER_CNT LEG1_TRAN_B_RAD_PER_CNT

#define RIGHT_MOTOR_A_DIRECTION  LEG1_MOTOR_A_DIRECTION
#define RIGHT_MOTOR_B_DIRECTION  LEG1_MOTOR_B_DIRECTION
#endif

#endif //LEG1_DEFINITIONS
