suxing304/atrias/software/atrias_controllers/atc_canonical_walking/src/ATCCanonicalWalking.cpp

#include "atc_canonical_walking/ATCCanonicalWalking.hpp"

// The namespaces this controller resides in
namespace atrias {
  namespace controller {
   
    //Simple constructor 
    ATCCanonicalWalking::ATCCanonicalWalking(string name) :
      ATC(name),
      ascHipBoomKinematics(this, "ascHipBoomKinematics"),
      pdLA(this, "pdLA"),
      pdLB(this, "pdLB"),
      pdLH(this, "pdLH"),
      pdRA(this, "pdRA"),
      pdRB(this, "pdRB"),
      pdRH(this, "pdRH"),
      rateLimLA(this, "rateLimLA"),
      rateLimLB(this, "rateLimLB"),
      rateLimLH(this, "rateLimLH"),
      rateLimRA(this, "rateLimRA"),
      rateLimRB(this, "rateLimRB"),
      rateLimRH(this, "rateLimRH"),
      rateLimTau(this, "rateLimTau")
    {
      // DRL Note: Removed startup controller setting -- we do our own smooth startup.

      // set the rate limit
      // DRL Note: Decreased rate limit to .3 -- we'd rather initialize too slow than too fast.
      rate = .3;
      
      // initialize the walking parameter
      init_param();
      init_pos();
      
      // initial stance leg is right leg
      sleg = LEFT_LEG;
      tau_prev = 0;
      cnt = 2;
      timer = 0;
    }
    
    void ATCCanonicalWalking::controller() {
      // The robot state is in an inherited member variable named rs
      // The controller output should be put in the inherited member co

      // Run the safeties
      checkLimits();
      
      // Update gains, and other options
      updateController();
      
      // DRL Note: This has been disabled so as to allow each controller to
      // specify different hip controller behavior. Now the standing and walking
      // controllers call this themselves.
      //// Run the hip controller
      //hipController();
      
      // Main controller state machine
      switch (controllerState) 
	{
	case STANDING: // Stand upright to desired initial position
	  // Call Standing controller
	  standingController();
	  break;
	case WALKING:
	  // Call Walking controller
	  walkingController();

	  // @TODO: update stance leg 'sleg'
	  //        For initial tracking test, we will only test one step. 
	  //        Therefore, we don't need to update stance leg for 
	  //        initial test. This can be added later.
          
	  break;
	case STOPPING:
	  // Call Stopping controller
	  stoppingController();
	  break;
	}

	// Clamp torques for safety.
	clampTorques();
    }
    
    void ATCCanonicalWalking::standingController(){
      isInitialized = true;

      /* The logOut class is an inherited member from ATC, and is of type
       * controller_log_data. guiIn, similarly, is of type
       * gui_to_controller
       */
      logOut.rqATgt = rateLimRA(pos_initial[0] - M_PI/2, rate);
      logOut.rqBTgt = rateLimRB(pos_initial[1] - M_PI/2, rate);
      logOut.lqATgt = rateLimLA(pos_initial[2] - M_PI/2, rate);
      logOut.lqBTgt = rateLimLB(pos_initial[3] - M_PI/2, rate);
      
      
      // Command the outputs (and copy to our logging data).
      // This is where the definition of ASCPD as a functor is convenient.
      // Legs
      // DRL Note: Added conversions of target position coordinates from Dr. Grizzle's system to ours.
      co.lLeg.motorCurrentA = pdLA(logOut.lqATgt, rs.lLeg.halfA.motorAngle, 0, rs.lLeg.halfA.rotorVelocity);
      co.lLeg.motorCurrentB = pdLB(logOut.lqBTgt, rs.lLeg.halfB.motorAngle, 0, rs.lLeg.halfB.rotorVelocity);
      co.rLeg.motorCurrentA = pdRA(logOut.rqATgt, rs.rLeg.halfA.motorAngle, 0, rs.rLeg.halfA.rotorVelocity);
      co.rLeg.motorCurrentB = pdRB(logOut.rqBTgt, rs.rLeg.halfB.motorAngle, 0, rs.rLeg.halfB.rotorVelocity);
      // @TODO: control hip motors here or not?
      // DRL Note: Inserting a call to the hip controller here, passing parameters that indicate that it
      // should smoothly initialize the hip position.
      hipController(true, false);

      // @TODO: add guiOut

    }
    
    void ATCCanonicalWalking::stoppingController(){
      // Compute and set motor currents (applies virtual dampers to all actuators)
      // @TODO: control hip motors here or not?
      co.lLeg.motorCurrentA = pdLA(0.0, 0.0, 0.0, rs.lLeg.halfA.rotorVelocity);
      co.lLeg.motorCurrentB = pdLB(0.0, 0.0, 0.0, rs.lLeg.halfB.rotorVelocity);
      co.rLeg.motorCurrentA = pdRA(0.0, 0.0, 0.0, rs.rLeg.halfA.rotorVelocity);
      co.rLeg.motorCurrentB = pdRB(0.0, 0.0, 0.0, rs.rLeg.halfB.rotorVelocity);

      // DRL Note: Added a call to the hip controller function, telling it to do hip relaxation
      hipController(false, true);
    }

    void ATCCanonicalWalking::walkingController(){
      double tau, dtau, tau_d;

      // convert states
      convert2torso();

      // compute 'tau', 'dtau'
      tau = compute_tau();
      
      // DEBUG STATEMENT REMOVE!!!
      
      dtau = compute_dtau();
      // @TODO: time-based trajectory
      // tau = (rs.timing.controllerTime-initial_controllerTime) % PERIOD;
      // dtau = 1;
      /*
      if (isInitialized) 
	{
	  tau_prev = tau;
	  isInitialized = false;
	}

      // @hacks we might not need this.
      if(abs(tau - tau_prev) < 0.009)	// stuck
	timer++;
      else  				// walking	
	{
	  timer = 0; 
	  cnt = 2;
	}
      if ( timer >= 10 )
	{ 
	  cnt += 1;
	  timer  = 0; 
	}
      */
      tau_d = tau;
      //Define a proper boundary conditions.
      if(tau_d >  1.0)	   tau_d =  1.00;
      if(tau_d < -0.001)   tau_d = -0.001;
      //printf("tau: %f, dtau: %f", tau, dtau);
      // compute desired outputs
      compute_y2d(tau_d);
      compute_y2dDot(tau_d, dtau);
      
      // compute desired motor angles through inverse kinematics
      phi_inverse_mat();
      
      // convert states
      convert2bodypitch();
      //printf("%f, %f\n",xa[1],xd[1]);
      // DRL Note: I've removed the rate limiting since it's unnecessary and is interfered with by the
      // rate limiter resetting used by the starting controller
      
      // Command the outputs (and copy to our logging data).
      // This is where the definition of ASCPD as a functor is convenient.
      // Legs
      co.lLeg.motorCurrentA = pdLA(qTgt[0], rs.lLeg.halfA.motorAngle, dqTgt[0], rs.lLeg.halfA.rotorVelocity);
      co.lLeg.motorCurrentB = pdLB(qTgt[1], rs.lLeg.halfB.motorAngle, dqTgt[1], rs.lLeg.halfB.rotorVelocity);
      co.rLeg.motorCurrentA = pdRA(qTgt[2], rs.rLeg.halfA.motorAngle, dqTgt[2], rs.rLeg.halfA.rotorVelocity);
      co.rLeg.motorCurrentB = pdRB(qTgt[3], rs.rLeg.halfB.motorAngle, dqTgt[3], rs.rLeg.halfB.rotorVelocity);
      // @TODO: control hip motors here or not?
      // DRL Note: Adding a call to hipController here.
      hipController(false, false);

      // @TODO: add guiOut

      if ( (TauSource) guiIn.tauMode == TauSource::STANCE_LEG_ANGLE) 
      {
        
        if (tau_d > 0.98)
        {
          if (sleg == LEFT_LEG )
            sleg = RIGHT_LEG;
          else
            sleg = LEFT_LEG;
        }
        /*
        if (sleg == LEFT_LEG)
        {
          double len_m, len_l;
          //compute right leg length from leg angle and motor angle
          len_m = sqrt(0.5*(1-cos(PI-(rs.rLeg.halfB.motorAngle-rs.rLeg.halfA.motorAngle))));
          len_l = sqrt(0.5*(1-cos(PI-(rs.rLeg.halfB.legAngle-rs.rLeg.halfA.legAngle))));
          if ((len_m - len_l) > 0.01)
          {
            sleg = RIGHT_LEG;
          }
        }
        else
        {
          double len_m, len_l;
          //compute right leg length from leg angle and motor angle
          len_m = sqrt(0.5*(1-cos(PI-(rs.lLeg.halfB.motorAngle-rs.lLeg.halfA.motorAngle))));
          len_l = sqrt(0.5*(1-cos(PI-(rs.lLeg.halfB.legAngle-rs.lLeg.halfA.legAngle))));
          if ((len_m - len_l) > 0.01)
          {
            sleg = LEFT_LEG;
          }
        }
        */
      }
    }

	void ATCCanonicalWalking::clampTorques() {
		co.lLeg.motorCurrentA   = clamp(co.lLeg.motorCurrentA, -guiIn.maxCurrent, guiIn.maxCurrent);
		co.lLeg.motorCurrentB   = clamp(co.lLeg.motorCurrentB, -guiIn.maxCurrent, guiIn.maxCurrent);
		co.lLeg.motorCurrentHip = clamp(co.lLeg.motorCurrentHip, -guiIn.maxCurrent, guiIn.maxCurrent);
		co.rLeg.motorCurrentA   = clamp(co.rLeg.motorCurrentA, -guiIn.maxCurrent, guiIn.maxCurrent);
		co.rLeg.motorCurrentB   = clamp(co.rLeg.motorCurrentB, -guiIn.maxCurrent, guiIn.maxCurrent);
		co.rLeg.motorCurrentHip = clamp(co.rLeg.motorCurrentHip, -guiIn.maxCurrent, guiIn.maxCurrent);
	}

	void ATCCanonicalWalking::checkLimits() {
		// Check velocity limits
		if (std::abs(rs.lLeg.halfA.rotorVelocity) > guiIn.maxSpeed ||
		    std::abs(rs.lLeg.halfB.rotorVelocity) > guiIn.maxSpeed ||
		    std::abs(rs.rLeg.halfA.rotorVelocity) > guiIn.maxSpeed ||
		    std::abs(rs.rLeg.halfB.rotorVelocity) > guiIn.maxSpeed ||
		    std::abs(rs.lLeg.hip.legBodyVelocity) > guiIn.maxSpeed ||
		    std::abs(rs.rLeg.hip.legBodyVelocity) > guiIn.maxSpeed)
		{
			// Something's moving too fast -- trigger the EStop.
			commandEStop();
		}

		// Check spring deflection limits
		if (std::abs(rs.lLeg.halfA.motorAngle - rs.lLeg.halfA.legAngle) > guiIn.maxDefl ||
		    std::abs(rs.lLeg.halfB.motorAngle - rs.lLeg.halfB.legAngle) > guiIn.maxDefl ||
		    std::abs(rs.rLeg.halfA.motorAngle - rs.rLeg.halfA.legAngle) > guiIn.maxDefl ||
		    std::abs(rs.rLeg.halfB.motorAngle - rs.rLeg.halfB.legAngle) > guiIn.maxDefl)
		{
			// We've hit a deflection limit, trigger the estop
			commandEStop();
		}
	}

	// @TODO: Maybe we don't need to include hip controller in this controller.
	// DRL Note: I've implemented all of this, including options used for the startup
	// and shutdown controllers.
	void ATCCanonicalWalking::hipController(bool start, bool stop) {
		// Reset the hip rate limiters if we're in the stopping phase or the robot is disabled
		if (!isEnabled()) {
			// Reset the hip rate limiters to the current hip positions
			rateLimLH.reset(rs.lLeg.hip.legBodyAngle);
			rateLimRH.reset(rs.rLeg.hip.legBodyAngle);
		}

		// Set hip controller toe positions
		LeftRight toePosition;
		toePosition.left = guiIn.left_toe_pos;
		toePosition.right = guiIn.right_toe_pos;

		// Compute inverse kinematics to keep lateral knee torque to a minimum
		double lhTgt;
		double rhTgt;
		std::tie(lhTgt, rhTgt) = ascHipBoomKinematics.iKine(toePosition, rs.lLeg, rs.rLeg, rs.position);

		// If we're not running the startup controller, set the hip position command directly
		// to the desired hip angles
		if (!start) {
			rateLimLH.reset(lhTgt);
			rateLimRH.reset(rhTgt);
		}

		// Do the rate limiting on hip position. The rate is currently hardcoded at .1 rad/s
		lhTgt = rateLimLH(lhTgt, .1);
		rhTgt = rateLimRH(rhTgt, .1);

		// Do position control on the hip positions
		co.lLeg.motorCurrentHip = pdLH(lhTgt, rs.lLeg.hip.legBodyAngle, 0.0, rs.lLeg.hip.legBodyVelocity);
		co.rLeg.motorCurrentHip = pdRH(rhTgt, rs.rLeg.hip.legBodyAngle, 0.0, rs.rLeg.hip.legBodyVelocity);
	}

    void ATCCanonicalWalking::updateController(){
      // Set gains
      // Legs
      pdLA.P = pdLB.P = pdRA.P = pdRB.P = guiIn.leg_pos_kp;
      pdLA.D = pdLB.D = pdRA.D = pdRB.D = guiIn.leg_pos_kd;

      // DRL Note: Adding gain settings for hip PD controllers
      // Hips
      pdLH.P = pdRH.P = guiIn.hip_pos_kp;
      pdLH.D = pdRH.D = guiIn.hip_pos_kd;

      // Main controller options
      // DRL Note: Re-enabling this, so the user can control the controller state.
      controllerState = (CtrlState) guiIn.main_controller;

      // Reset the rate limiters if we're enabled and running the starting controller
      // Otherwise, there would be a jump when entering the starting controller.
      if (controllerState != STANDING || !isEnabled()) {
	rateLimLA.reset(rs.lLeg.halfA.motorAngle);
	rateLimLB.reset(rs.lLeg.halfB.motorAngle);
	rateLimRA.reset(rs.rLeg.halfA.motorAngle);
	rateLimRB.reset(rs.rLeg.halfB.motorAngle);
      }
    }

    
    
    /**
     * @brief This is to initialize the walking parameters.
     */
    void ATCCanonicalWalking::init_param(){
      // @TODO: We might need to figure out a proper way to initialize 
      //        parameter in the case it changes frequently.
      //        2 possible options: 1) From config file or 
      //                            2) From GUI input
      int i,j;
      for(i=0; i<N_OUTPUTS; i++)
	{
	  for(j=0; j<N_PARAMS; j++ )
	    {
	      param_mat[i][j] = A_OPT[i][j];
	    }
	}

      theta_limit1	= P_LIMITS[0];
      theta_limit2	= P_LIMITS[1];
    }
    
    /**
     * @brief This is to set the initial position for walking.
     */
    void ATCCanonicalWalking::init_pos(){
      // @TODO: We might need to figure out a proper way to set 
      //        initial position in the case it changes frequently.
      //        2 possible options: 1) From config file or 
      //                            2) From GUI input

      // This is assuming starting from right leg stance.
      for(int i=0; i<N_MOTORS; i++)
	pos_initial[i] = X_OPT[i];
      
    }
    
    /**
     * @brief This is to compute the inverse kinematics of the system.
     */
    void ATCCanonicalWalking::phi_inverse_mat(){
      int i,j;

      // Clear xd
      for (i = 0; i < N_STATES; ++i)
      	xd[i] = 0;

      // Calculate the new xd
      for(i=0; i<N_OUTPUTS; i++)
	{
	  for(j=0; j<N_OUTPUTS; j++ )
	    {
              xd[i+1] += invT[i][j] * y2d[j];
	      xd[i+6] += invT[i][j] * y2dDot[j];
            }
        }
      
    }
    
	/**
	* @brief This is to compute the phase (parameterized time) 'tau'
	*/
	double ATCCanonicalWalking::compute_tau(){	
		// The tau calculation depends on the tau source
		switch ((TauSource) guiIn.tauMode) {
			case TauSource::GUI:
				// Reset tau rate limiter if we're just initializing
				if (isInitialized)
					rateLimTau.reset(guiIn.manualTau);
                                double th, tau;
				th = PI*3/2 - (xa[0]+(xa[1]+xa[2])/2);
				tau = (th-theta_limit1)/(theta_limit2-theta_limit1);
                                printf("Actual Tau: %6.4f \n", tau);
				return rateLimTau(guiIn.manualTau, guiIn.maxTauRate);

			case TauSource::STANCE_LEG_ANGLE: {
				double th, tau;
				th = PI*3/2 - (xa[0]+(xa[1]+xa[2])/2);
				tau = (th-theta_limit1)/(theta_limit2-theta_limit1);

				// Reset tau's rate limiter so it doesn't jump when going into
				// manual tau mode
				rateLimTau.reset(tau);

				return tau;
			}

			default:
				// If the tau mode isn't recognized, trigger the EStop and return a dummy value.
				commandEStop();
				return 0.0;
		}
	}
    
	/**
	* @brief This is to compute the time derivative of 'tau'
	*/
	double ATCCanonicalWalking::compute_dtau(){	
		// The tau calculation depends on the tau source
		switch ((TauSource) guiIn.tauMode) {
			case TauSource::GUI:
				// 0.0 -- the GUI should command steps in tau
				return 0.0;

			case TauSource::STANCE_LEG_ANGLE: {
				double dtau;
				dtau = -(xa[5]+(xa[6]+xa[7])/2)/(theta_limit2-theta_limit1);
				//dtau = 0.0;
				return dtau;
			}

			default:
				// Unrecognized tau mode should cause an EStop.
				commandEStop();
				return 0.0;
		}
	}

    /**
     * @brief This is to compute the desired output 'y2d'
     * @param tau The parameterized time
     */
    void ATCCanonicalWalking::compute_y2d(double tau){
      // y2d = exp(-a4*t) * (a1*cos(a2*t)+a3*sin(a2*t)) + a5;
      //
      for(int j=0; j<N_OUTPUTS; j++)
	{ 
	  y2d[j] = exp(-param_mat[j][3]*tau) * 
	    (param_mat[j][0] * cos(param_mat[j][1]*tau) + 
	     param_mat[j][2] * sin(param_mat[j][1]*tau)) + 
	    param_mat[j][4];
	}
    }
    
    /**
     * @brief This is to compute the desired time derivative (velocity) of 'y2d'
     * @param tau The parameterized time
     * @param dtau The derivative of parameterized time
     */
    void ATCCanonicalWalking::compute_y2dDot(double tau, double dtau){
      // 
      for(int j=0; j<N_OUTPUTS; j++)
	{ 
	  y2dDot[j] =	exp(-param_mat[j][3]*tau) * 
	    ( param_mat[j][1] * param_mat[j][2]*cos(param_mat[j][1]*tau)- 
	      param_mat[j][0] * param_mat[j][1]*sin(param_mat[j][1]*tau))
	    - param_mat[j][3] * exp(-param_mat[j][3]*tau) *
	    ( param_mat[j][0] * cos(param_mat[j][1]*tau) +
	      param_mat[j][2] * sin(param_mat[j][1]*tau));
	  y2dDot[j] *=  dtau;		//noted
	}
    }
    
    /**
     * @brief This is to convert the states from the current coordinate configuration to the old (Dr Grizzle's) configuration.
     */
    void  ATCCanonicalWalking::convert2torso(){
      //
      if (sleg == LEFT_LEG) 
	{
	  xa[0] = rs.position.bodyPitch - 3 * PI/2;
	  xa[1] = rs.lLeg.halfA.legAngle + PI/2;
          
	  xa[2] = rs.lLeg.halfB.legAngle + PI/2;
          //printf("%6.4f %6.4f \n",rs.lLeg.halfA.motorAngle, rs.lLeg.halfB.motorAngle);
          
          xa[3] = rs.rLeg.halfA.legAngle + PI/2;
	  xa[4] = rs.rLeg.halfB.legAngle + PI/2;
	  xa[5] = rs.position.bodyPitchVelocity;
	  xa[6] = rs.lLeg.halfA.legVelocity;
	  xa[7] = rs.lLeg.halfB.legVelocity;
	  xa[8] = rs.rLeg.halfA.legVelocity;
	  xa[9] = rs.rLeg.halfB.legVelocity;
	} 
      else 
	{ //sleg = RIGHT_LEG
	  xa[0] = rs.position.bodyPitch - 3 * PI/2;
	  xa[1] = rs.rLeg.halfA.legAngle + PI/2;          
	  xa[2] = rs.rLeg.halfB.legAngle + PI/2;
	  xa[3] = rs.lLeg.halfA.legAngle + PI/2;
	  xa[4] = rs.lLeg.halfB.legAngle + PI/2;
	  xa[5] = rs.position.bodyPitchVelocity;
	  xa[6] = rs.rLeg.halfA.legVelocity;
	  xa[7] = rs.rLeg.halfB.legVelocity;
	  xa[8] = rs.lLeg.halfA.legVelocity;
	  xa[9] = rs.lLeg.halfB.legVelocity;
	}
      // 
    }
    
    
    /**
     * @brief This is to convert the states from the old (Dr. Grizzle's)  coordinate configuration to the current configuration.
     */
    void ATCCanonicalWalking::convert2bodypitch(){
      //
      if (sleg == LEFT_LEG) 
	{
	  qTgt[0] = xd[1] - PI/2;   // lLeg.halfA.motorAngle
          //          printf("Left Leg Angle: %f\n",qTgt[0]);
	  qTgt[1] = xd[2] - PI/2;   // lLeg.halfB.motorAngle
	  qTgt[2] = xd[3] - PI/2;   // rLeg.halfA.motorAngle
	  qTgt[3] = xd[4] - PI/2;   // rLeg.halfB.motorAngle
	  dqTgt[0] = xd[6];         // lLeg.halfA.motorVelocity
	  dqTgt[1] = xd[7];         // lLeg.halfB.motorVelocity
	  dqTgt[2] = xd[8];         // rLeg.halfA.motorVelocity
	  dqTgt[3] = xd[9];         // rLeg.halfB.motorVelocity
	} 
      else 
	{ //sleg = RIGHT_LEG
	  qTgt[0] = xd[3] - PI/2;   // lLeg.halfA.motorAngle
	  qTgt[1] = xd[4] - PI/2;   // lLeg.halfB.motorAngle
	  qTgt[2] = xd[1] - PI/2;   // rLeg.halfA.motorAngle
	  qTgt[3] = xd[2] - PI/2;   // rLeg.halfB.motorAngle
	  dqTgt[0] = xd[8];         // lLeg.halfA.motorVelocity
	  dqTgt[1] = xd[9];         // lLeg.halfB.motorVelocity
	  dqTgt[2] = xd[6];         // rLeg.halfA.motorVelocity
	  dqTgt[3] = xd[7];         // rLeg.halfB.motorVelocity
	}
      // 
    }
    
    
    ORO_CREATE_COMPONENT(ATCCanonicalWalking)
    
  }
}
