suxing304/atrias/software/atrias_control_lib/include/atrias_control_lib/LogPort.hpp

#ifndef LOGPORT_HPP
#define LOGPORT_HPP

/**
  * @file LogPort.hpp
  * @author Ryan Van Why
  * @brief This class allows subcontrollers to log data.
  * This may also be utilized by top-level controllers
  * for additional log ports.
  */

// Orocos includes
#include <rtt/ConnPolicy.hpp>       // Allows for connecting the output port to ROS
#include <rtt/OutputPort.hpp>       // This allows the creation of an output port
#include <rtt/os/oro_allocator.hpp> // Lets us send messages in HRT

// ATRIAS
#include <atrias_shared/RtMsgTypekits.hpp>         // Lets us register a typekit for this message.
#include "atrias_control_lib/AtriasController.hpp" // This allows us to access the name and TaskContext

namespace atrias {
namespace controller {

template <template <class> class logType>
class LogPort {
	public:
		/**
		  * @brief The constructor for this logging port.
		  * @param controller A reference to this controller
		  * @param name       The name for this log port.
		  */
		LogPort(const AtriasController* const controller, const std::string name = "log");

		/**
		  * @brief This allows controllers to access the data to be logged.
		  */
		//logType<RTT::os::rt_allocator<uint8_t>> data;
		logType<std::allocator<void>> data;

		/**
		  * @brief This transmits the data for logging.
		  * This will not alter the data itself.
		  */
		void send();
	
	private:
		// Our output port
		//RTT::OutputPort<logType<RTT::os::rt_allocator<uint8_t>>> port;
		RTT::OutputPort<logType<std::allocator<void>>> port;

		// Allows us to access the top-level controller.
		const AtriasController &tlc;
};

template <template <class> class logType>
LogPort<logType>::LogPort(const AtriasController* const controller, const std::string name) :
	port(controller->getName() + "_" + name),
	tlc(controller->getTLC())
{
	// Register typekit
	//shared::RtMsgTypekits::registerType<logType>(controller->getName() + "_" + name);

	// Setup our port
	this->tlc.getTaskContext().addPort(this->port);

	RTT::ConnPolicy policy = RTT::ConnPolicy::buffer(10000);
	// Transport 3 is ROS
	policy.transport = 3;
	// Set the topic name
	policy.name_id = "/" + controller->getName() + "_" + name;
	// And actually initiate the connection
	this->port.createStream(policy);
}

template <template <class> class logType>
void LogPort<logType>::send() {
	// Set the timestamp
	this->data.header = this->tlc.getROSHeader();

	// Send the data
	this->port.write(this->data);
}

}
}

#endif // LOGPORT_HPP

// vim: noexpandtab
