suxing304/atrias/firmware/tests/menial_amplifier_uart/main.c

#include <avr/io.h>
#include <util/delay.h>

#include "cpu.h"
#include "uart.h"

UART_USES_PORT(USARTE0)
UART_USES_PORT(USARTD0)

int main(void) {
	cpu_set_clock_source(cpu_32mhz_clock);
	cpu_configure_interrupt_level(cpu_interrupt_level_medium, true);

	uint8_t outbuffer[128];
	uint8_t inbuffer[128];
	uart_port_t debug_port = uart_init_port(&PORTE, &USARTE0, uart_baud_115200, outbuffer, 128, inbuffer, 128);
	uart_connect_port(&debug_port, true);
	
	uint8_t outbuffer_amp[128];
	uint8_t inbuffer_amp[128];
	uart_port_t amp_port = uart_init_port(&PORTD, &USARTD0, uart_baud_115200, outbuffer_amp, 128, inbuffer_amp, 128);
	uart_connect_port(&amp_port, false);

	printf("Menial Amplifier UART Test.....\n> ");

	uint8_t newchar;
	while (1) {
		if (uart_received_bytes(&debug_port) > 0) {
			uart_tx_byte(&amp_port,uart_rx_byte(&debug_port));
		}
		if (uart_received_bytes(&amp_port) > 0) {
			newchar = uart_rx_byte(&amp_port);
			if (newchar == 13)
				printf("\n> ");
			else
				uart_tx_byte(&debug_port,newchar);
		}
	}

	while(1);
	return 1;
}
