suxing304/atrias/software/atrias/scripts/autoschwarzebagger.py

#!/usr/bin/env python2

import sys
import os
import glob
import subprocess

if (len(sys.argv) < 3):
    print("This script runs fix_bag.py and bag2mat.py on all bagfiles found in")
    print("the source directory and outputs to a target directory, preserving")
    print("subdirectory structure.\n")
    print("Usage: " + sys.argv[0] + " [1] [2] [3]\n")
    print("    1: Directory containing bagfiles to convert")
    print("    2: Directory for fixed bagfiles and output MATLAB files")
    print("    3: Number of threads to use (default is 1)\n")
    exit()

# Declare some colors.
class pColors:
    HEADER = '\033[95m'
    OKBLUE = '\033[94m'
    OKGREEN = '\033[92m'
    WARNING = '\033[93m'
    FAIL = '\033[91m'
    ENDC = '\033[0m'

# Get list of files to convert.
origFilenames = glob.glob(sys.argv[1]+"/**/**/*.bag")
targetFilenames = [x.replace(sys.argv[1]+'/', '', 1).replace('.bag', '') for x in origFilenames]

print "Files to convert:\n"
for f in origFilenames:
    print "    " + f
print ""

# Prompt for go-ahead.
goAhead = raw_input("Proceed? (Y/n): ")
if goAhead not in ['Y', 'y', '']:
    exit()

# Get (sub)directories containing bagfiles.
dirList = []
walk = os.walk(sys.argv[1])
for path, dirs, files in walk:
    bagfiles = glob.glob(path+"/*.bag")
    if len(bagfiles) > 0:
        dirList.append(path)

# Escape spaces in paths.
for name in dirList:
    name = name.replace(' ', '\ ')

# Create necessary subdirectories.
for path in dirList:
    subprocess.call(["mkdir", "-p", path.replace(sys.argv[1], sys.argv[2], 1)])

# Set maximum number of threads to use.
maxNumThreads = 1
if len(sys.argv) > 3:
    maxNumThreads = sys.argv[3]

# Initialize list of processes to spawn.
procList = []
nextFileToProc = 0

# Run fix_bag.py
print pColors.HEADER + "Running fix_bag.py\n" + pColors.ENDC

while True:
    # Spawn off new conversion processes.
    while len(procList) < int(maxNumThreads) and nextFileToProc < len(origFilenames):
        procList.append(subprocess.Popen(["rosrun", "atrias", "fix_bag.py", origFilenames[nextFileToProc], sys.argv[2]+"/"+targetFilenames[nextFileToProc]+'_fixed.bag']))
        print "[" + str(nextFileToProc+1) + "/" + str(len(origFilenames)) + "] " + pColors.OKBLUE + origFilenames[nextFileToProc] + pColors.ENDC
        nextFileToProc += 1

    # Remove complete processes from list.
    procList = filter(lambda y: y.poll() == None, procList)

    if len(procList) == 0 and nextFileToProc == len(origFilenames):
        break;

# Reset things.
nextFileToProc = 0

# Run bag2mat.py
print pColors.HEADER + "\nRunning bag2mat.py\n" + pColors.ENDC
while True:
    # Spawn off new conversion processes.
    while len(procList) < int(maxNumThreads) and nextFileToProc < len(origFilenames):
        procList.append(subprocess.Popen(["rosrun", "atrias", "bag2mat.py", sys.argv[2]+'/'+targetFilenames[nextFileToProc]+'_fixed.bag', sys.argv[2]+'/'+targetFilenames[nextFileToProc]+'.mat']))
        print "[" + str(nextFileToProc+1) + "/" + str(len(origFilenames)) + "] " + pColors.OKBLUE + origFilenames[nextFileToProc] + pColors.ENDC
        nextFileToProc += 1

    # Remove complete processes from list.
    procList = filter(lambda y: y.poll() == None, procList)

    if len(procList) == 0 and nextFileToProc == len(origFilenames):
        break;

print "\nHasta la vista, baby."
