suxing304/atrias/(commit log)

2011-10-04 wireless_kern_interface can now be run as normal user instead of root. Commented out portion of ldmod script that checks for rtai prefix.
2011-10-04 Add soft symlinks in ecat_master. I don't know why they are there, but just in case.
2011-10-24 Motor angles should be drawn after leg angles so they show up above the legs.
2011-10-24 Account for motor angle to leg angle offset.
2011-10-26 Edit GUI visual elements and change Leg Position tab constraints to safe values.
2011-10-27 GUI logfiles are now created based on date and time. No more crashing when checking Log Data.
    [atrias_gui.cpp]
2011-10-27 wireless_kern_interface no longer runs in separate terminal.
2011-10-28 Comment out data logging from wireless_kern_interface. Data logging should be performed by separate ROS node.
2011-10-31 Recalibrate encoders.
2011-11-03 data_publisher needs to publish at a certain loop rate. This shouldn't be the case. Need to fix.
2011-11-04 GUI still doesn't update log_file_chooser properly. Head hurts. Calling it a day.
    [atrias_gui.cpp]
2011-11-04 Abandon FileChooserButton bug for now. Logging works, anyway. GUI and data_subscriber output pretty ROS_INFO messages.
    [atrias_gui.cpp]
2011-11-08 Logfile parser automatically labels title and axes and sets X and Y axis limits.
2011-11-30 Display spring deflection values.
2011-12-09 Added design files for DC/DC converter board
    [ATRIAS_PowerSupply.brd, ATRIAS_PowerSupply.sch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]
2011-12-20 SOEM driver for Medullas.
2011-12-22 More digits for spring deflections.
2011-12-22 SOEM driver spits out consistent gibberish.
2011-12-23 Fix leg length sine wave controller.
    [atrias_gui.cpp]
2012-01-01 Refactor SOEM Medulla driver.
2012-01-03 Bug fixes to rtai_controller, added force controller to rtai_controller and gui, and fixed leg length sinewave controller.
    [atrias_gui.cpp, controller_wrapper_states.c]
2012-01-04 Added desired spring defelction to force controller. Added leg_force_controller.cpp to respository (forgot to add it in previous commit).
2012-01-04 Cleaned up medulla.1.5 code, added toe switch to medulla code.
2012-01-04 Fixed bugs with enabling motor amplifiers.
    [medulla.c]
2012-01-04 Implemented toe switch in controller_wrapper_states.c
2012-01-05 Added thermistor input to controller_wrapper_states.c. Modified leg_force_controller.c to use position control.
2012-01-05 Added medulla ADC library and implemented thermistor measurement.
2012-01-06 Fixed bugs in leg force controller, added rotor velocity read out to GUI. Leg position controller now initilizes it's position to the current position of the leg.
    [atrias_gui.cpp, controller_wrapper_states.c]
2012-01-09 Implemented new method of calibrating 32 bit encoders.
2012-01-10 Fix indentation for controller_wrapper_states.c.
    [controller_wrapper_states.c]
2012-01-11 Fixed bugs in leg force controller. Added voltage monitoring to controller_wrapper_states.c
    [controller_wrapper_states.c]
2012-01-11 Added motor damping regions to medulla code.
2012-01-12 Fixed watchdog timer in medulla code. Debounced thermistor and voltage inputs to deal with noise issues. The files step_timer.c/h have been renamed to timer.c/h because they have been generalized to 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
    [medulla.c]
2012-01-14 Worked on leg force controller
2012-01-14 Medulla code now reports error flags. Added error flag defines to ucontroller.h
    [medulla.c]
2012-01-17 moved vars from msg to srv. added temp and voltage update code
2012-01-17 Angles are now computed from a single calibration position.
2012-01-17 started the error code detection and gui update
    [atrias_gui.cpp]
2012-01-18 Corrected thermistor outputs in GUI. Kernel module reports medulla status to shared memory. wireless kernel interface sends medulla status in ros message to GUI.
    [atrias_gui.cpp, controller_wrapper_states.c]
2012-01-19 condenced the error display down to one label. The text of the label changes to the occured error. This has not been tested yet on the hardware
    [atrias_gui.cpp]
2012-01-20 added medulla error detection logic
    [atrias_gui.cpp]
2012-01-23 added widgets for spring progress bar. It does not display yet
2012-01-25 Added incremental encoder to medulla code
2012-01-26 Restructured medulla code to facilitate the addition of new types of medullas. The code for all types of medullas (leg, hip, boom, etc...) will reside in one xMega program, and be selected using the 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
2012-02-02 Makeshift stance/flight sensing with spring deflections.
2012-02-02 RaibertControllerState struct keeps track of time like sine wave controller.
2012-02-02 Increase Raibert controller PID gain limits.
2012-02-05 Added menial board schematic and design files.
    [menial_board_v2.brd, menial_board_v2.sch]
2012-02-06 Edit CMakeList.txt to include the leg force controller.
2012-02-07 Added simTestHeader.urdf.xacro
    [simTestHeader.urdf.xacro]
2012-02-07 Correct model reference
    [simTestHeader.urdf.xacro]
2012-02-07 Added simTest.urdf.xacro, which is the first attempt at a test simulation
    [simTest.urdf.xacro]
2012-02-08 Raibert Controller now uses toe switch and controls hip angle.
2012-02-08 Updated calibration values.
2012-02-08 Modify to rotate visual axes because cylinders spawn with axis along z-axis.
    [simTest.urdf.xacro]
2012-02-08 Modify to fix mistake in previous commit: rotating visual axis about x-axis instead of y-axis. Is now visually correct.
    [simTest.urdf.xacro]
2012-02-09 Added hip actuator and boom encoder inputs and outputs to kernel module. added hip gain controls to GUI. Removed extra variables in controller input struct. This may have broken some things in data l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
    [atrias_gui.cpp, controller_wrapper_states.c]
2012-02-10 Properly report motor and logic voltages.
2012-02-10 Added data processing matlab script
    [ATRIAS_2.0_Amp_Stack.DXF]
2012-02-10 Added header files for boom testing
    [boomTestHeader.urdf.xacro]
2012-02-10 Added previous encoder value field to the uControllerOutput struct.
2012-02-13 Create simple boom with a vertical link and a horizontal link that rotates about the z-axis.
    [boomTest.urdf.xacro]
2012-02-13 As of now, this generates an overconstrained (?) swinging pendulum. It's twitchy, but it runs.
    [simTest.urdf.xacro]
2012-02-13 adds a simple pendulum
    [boomTest.urdf.xacro]
2012-02-13 The correct x-axis moment of inertia now causes a 2-second period of oscillation. Note that y- and z-axis moments of inertia needed to be set to an arbitrary non-zero value or else the period was too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
    [boomTest.urdf.xacro]
2012-02-15 Fix typo in "bodyName does not exist" error so the correct bodyName is listed in the error text.
    [spring.cpp]
2012-02-16 Merged leg code with hip and boom code, there is now a single code base for all the medullas. Fixed toe switch. Timestep now reports the current medulla time and does not reset when the computer read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
    [medulla.c, medulla_hip.c, medulla_leg.c, medulla_leg.h]
2012-02-17 Velocities for leg and hip are now calculated based upon internally calculated time steps instead of time steps reported by medulla.
2012-02-17 Add a spring and a controller that publishes a 3D position topic. The predicted and actual period of oscillation is now T=1.5s.
    [boomTest.urdf.xacro]
2012-02-18 Motor pass through can now triggered by setting the DIP switches to 0b0000. Motor power cutoff now only triggers when the voltage is between 3 and 44 volts. This way when the motor power cutoff only 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
2012-02-22 Correct document for ATRIAS 2.0 leg motor documentation.
2012-02-22 Correct documentation info for ATRIAS 2.0 hip motor
2012-02-23 Template for Atrias 2.0
    [simTest.urdf.xacro]
2012-02-24 Starting to make planar model. Currently broken.
    [simTest.urdf.xacro]
2012-02-24 Planar constraint working
    [simTest.urdf.xacro]
2012-02-25 Correct inertias for Atrias 2.0
    [simTest.urdf.xacro]
2012-02-27 Rename from simTest.urdf.xacro and comment a few things.
    [atrias20_planar.urdf.xacro]
2012-02-27 Paste all-in-one controller stuff back into code; renamed links in that call to match the model file. Add comments.
    [atrias20_planar_header.urdf.xacro]
2012-02-27 Revert to Soo-Hyun's revision, which includes the position body gui, even though it's currently broken.
2012-02-28 New package atrias_sim.
    [all_in_one.urdf.xacro, atrias.urdf.xacro, atrias20_leg.urdf.xacro, atrias20_planar_constraint.urdf.xacro, atrias20_planar_header.urdf.xacro, boomTest.urdf.xacro, boomTestHeader.urdf.xacro, ecat.urdf.xacro]
2012-02-28 Move stuff over to atrias_sim.
    [all_in_one.urdf.xacro, atrias.urdf.xacro, atrias20_planar.urdf.xacro, atrias20_planar_header.urdf.xacro, boomTest.urdf.xacro, boomTestHeader.urdf.xacro, ecat.urdf.xacro]
2012-02-29 Split atrias20 into multiple files.
    [atrias20_leg.urdf.xacro, atrias20_planar_header.urdf.xacro, planar_constraint.urdf.xacro]
2012-03-02 Boom template
    [atrias20_boom_header.urdf.xacro, atrias20_leg.urdf.xacro, boom21.urdf.xacro]
2012-03-05 Correct boom inertias
    [atrias20_boom_header.urdf.xacro, atrias20_leg.urdf.xacro, boom21.urdf.xacro]
2012-03-05 ucontroller.h - recalibrated leg encoders parse_log.py - added new columns to help display controller_wrapper_states.c - leg encoders now autocalibrate to zero out spring deflections. Added reading b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
    [atrias_gui.cpp, controller_wrapper_states.c]
2012-03-05 Hip commands are not properly clamped
2012-03-05 Added contril_switcher_state_machine files back into atrias_controllers. I don't know why they were removed, but they are needed to compile the rtai_controller module. Added hip torque and velocity d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
2012-03-06 Added Body pitch code to medulla firmware.
2012-03-06 GUI now displays error flags for all medullas
    [atrias_gui.cpp, controller_wrapper_states.c]
2012-03-07 Planar and Boom models completely defined and functional
    [atrias20_boom_header.urdf.xacro, atrias20_leg.urdf.xacro, atrias20_planar_header.urdf.xacro, boom21.urdf.xacro]
2012-03-08 Added detail drawing for the Amplifier Breakout Board
2012-03-09 Added and completed biped template. Working.
    [atrias20_boom_header.urdf.xacro, atrias20_leg.urdf.xacro, atrias20_planar_header.urdf.xacro, boom21.urdf.xacro]
2012-03-09 Complete biped template. Working.
    [atrias20_biped_boom_header.urdf.xacro, atrias20_biped_planar_header.urdf.xacro, atrias20_torso.urdf.xacro]
2012-03-09 Added pin out documentation images for menial board 2.0
2012-03-09 Corrected last boom joint for biped
    [boom21.urdf.xacro]
2012-03-12 Added design files for menial 2.1 board.
    [menial_board_21.sch]
2012-03-13 More work on menial 2.1 board
    [menial_board_21.sch]
2012-03-15 added motor winding specs for ATRIAS 2.1
2012-03-15 Controller working with friction
    [atrias20_leg.urdf.xacro, boomTest.urdf.xacro, planar_constraint.urdf.xacro]
2012-03-16 Modifications for controller testing
    [atrias20_leg.urdf.xacro, planar_constraint.urdf.xacro]
2012-03-22 Finished drawing up menial-2.1 board schematic. The schematic still needs to be reviewed, then I can start laying out the PCB.
    [menial_board_21.sch]
2012-03-22 Fixed mistakes in menial 2.1 schematic.
    [menial_board_21.sch]
2012-03-30 Make data_subscriber catch exception if /mnt/hurst is not mounted.
2012-03-31 Finished routing menial 2.1 board design,
    [menial_board_21.sch]
2012-04-03 Added menial 2.1 board file because I just realized it wasn't in the repository. Finished placing of component designators and values on board.
    [menial_board_21.pcb, menial_board_21.sch]
2012-04-03 Finished checking Menial 2.1 board for errors. It is now ready to generate gerber files and ship out for manufacturing.
    [menial_board_21.pcb]
2012-04-04 Update calibration values.
2012-04-04 Added board name to silkscreen of menial 2.1 board. Designed, laid out and routed amplifier breakout board.
    [amp_breakout_v1.pcb, amp_breakout_v1.sch, menial_board_21.pcb, menial_board_21.sch]
2012-04-04 Ran error check on fixed errors on amplifier breakout board. The board is ready to generate gerbers.
    [amp_breakout_v1.pcb]
2012-04-04 Remove gui.
    [atrias20_leg.urdf.xacro]
2012-04-16 Added the inverted pendulum controller. Currently working.
2012-04-20 Rewrite data_logger to log all data on nettop and publish a 50 hz stream over wireless.
2012-04-23 Broke the inverted pendulum files up
    [inverted_pendulum_header.urdf.xacro, inverted_pendulum_mass.urdf.xacro, inverted_pendulum_toe.urdf.xacro]
2012-04-23 Added a toe
    [inverted_pendulum_toe.urdf.xacro, inverted_pendulum_with_toe_header.urdf.xacro]
2012-04-24 Set data sample on data output port and add memory locks.
2012-04-25 Added inverted pendulum with toe at proper heights
    [inverted_pendulum_toe.urdf.xacro, inverted_pendulum_with_toe_header.urdf.xacro]
2012-04-26 Changed leg motor current scaling for one amplifier.
2012-04-30 boom encoder won't roll over
    [controller_wrapper_states.c]
2012-05-01 leg force controller now controlls actual forces (not just spring deflections)
2012-05-01 Added a motor torque square generator controller, the file is designed to replace the sine wave controller when you want to use it. The raibert controller isn't really a raibert controller now, but I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
2012-05-02 Modified kernel module to run without boom encoder. Fixed bugs in demo controller, at this point it's basically working. Still need to add seperate gains for the hip.
    [controller_wrapper_states.c]
2012-05-03 Archive a couple more packages and rename another
2012-05-09 Made it work
    [inverted_pendulum_toe.urdf.xacro]
2012-05-18 Added hardware to menial board 2.1 to communicate with strain gauge digitizer board.
    [menial_board_21.pcb, menial_board_21.sch]
2012-05-18 Generated CAM files for menial board 2.1
    [menial_board_21.pcb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]
2012-05-25 Added strain gauge digitizer board. The schematic is complete, the board has been routed, but needs to be checked. I also added CAM files for the amplifier breakout board.
    [amp_breakout_v1.pcb, strain_gauge_digitizer_v1.pcb, strain_gauge_digitizer_v1.sch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]
2012-05-30 strain gauge digitizer board is almost done. I need to consider what changes moving to right angle connectors would require
    [strain_gauge_digitizer_v1.pcb, strain_gauge_digitizer_v1.sch]
2012-06-01 I have verified all our PCB CAM files with the manufacturer's service. I had to make a few changes, but the files are ready to go.
    [amp_breakout_v1.pcb, menial_board_21.pcb, strain_gauge_digitizer_v1.pcb, strain_gauge_digitizer_v1.sch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]
2012-06-01 This change should automatically calibrate the hip encoder at startup. There is a hard coded range of encoder values, and the base values is read when the medulla initializes. This should work, assum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
2012-06-01 added dimensional drawing for strain gauge digitizer board.
2012-06-01 Fixed DC/DC converter board.
    [ATRIAS_PowerSupply.brd, ATRIAS_PowerSupply.sch, menial_board_21.pcb, strain_gauge_digitizer_v1.pcb]
2012-06-12 Added BOMs for menial board v2.1, amp breakout board v1, and strain gauge amplifier v1
    [BOM.ods, menial_board_21.sch]
2012-06-13 Cleaning up firmware directory: Removed medulla.1 files from SVN because they are not useful anymore. Moved medulla.1.5 files into the firmware directory and removed the medulla.1.5 directory.
    [BOM.ods]
2012-06-14 Fixed robot height problem, the maximum torque is now 120 amps
    [controller_wrapper_states.c]
2012-06-21 Fixed bugs found in menial_board_2.1 after manufacturing.
    [menial_board_21.pcb, menial_board_21.sch]
2012-06-27 Fixes to includes to fix reletive path to ucontroller.h and fixed bug in amp.c cause be a descrepency between windows avr-libc and linux-libc
    [medulla.c, medulla_boom.h, medulla_hip.h, medulla_leg.h]
2012-06-28 Added ethercat ESC files
2012-07-03 Added Xmega Driver Folder with preliminary adc and uart drivers
2012-07-03 Fixed a bug in uart driver that would not cause characters not to be transmitted if single bytes were written into the buffer too fast
    [uart.c, uart.h]
2012-07-03 Fixing demo controller and adding more debug checks to control switcher state machine
2012-07-03 Adding two new limit switches to the robot state ROS message
2012-07-03 Added limit switches for display on the gui
2012-07-04 Finally tested most of the features of the SPI driver. Fixed some bugs, the only thing left to implement is CS handling
2012-07-04 Finished documenting spi driver
2012-07-05 Adding in some of my work on the ECat Master rewrite. Will be removing some of these shortly to switch to SOEM-only (w/ no plans for autoconfig under Etherlab's master).
2012-07-06 Finished (for the most part) and tested the medulla_lib ethercat driver. Modified the medulla ESI file to add slave types for the different medullas, they now contain all the data that will actually 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
2012-07-06 Finished commenting ethercat and SPI drivers.
2012-07-06 Added files for starting PWM generator. Also added ethercat.c, because apparently I forgot to add it before.
2012-07-09 Added PWM library. Fixed bug in uart code that would cause it not to run the receive interrupt on port D. Removed debugging code from ethercat.c
    [uart.h]
2012-07-10 Disable planar button. Add names to demo controllers 5 and 6.
2012-07-10 Remove debug printf.
2012-07-10 Make radio buttons not overlap.
2012-07-10 Make GUI report triggered limit switch numbers.
2012-07-13 Added limit switch and E-Stop drivers
2012-07-16 Committing some changes I have remaining in my hardware directory. I'm not sure what they are, but for one they fix the problem with the incremental encoder differential receiver.
    [menial_board_21.sch]
2012-07-18 Finished revising menial board, added differential driver board for incremental encoders.
    [encoder_differential_driver_v1.pcb, encoder_differential_driver_v1.sch, menial_board_21.sch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]
2012-07-18 Switched the ADC on the strain gauge digitizer board to an ADC with an easier to use interface. I also moved the trimmer potentiometers apart by 40 mils so it is easier to solder them as well as othe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
    [strain_gauge_digitizer_v1.pcb, strain_gauge_digitizer_v1.sch]
2012-07-19 Changed the way interrupt handlers are included in the user program for the spi uart and ethercat drivers. Added and documented the a Biss-C driver.
2012-07-20 Fixed Biss-C encoder driver. It no longer tries to asyncronously wait for the Ack.
    [biss.c, biss.h]
2012-07-20 Added SSI encoder driver. Removed some now unused code from the biss driver.
2012-07-21 Renamed files and functions for biss and ssi encoders. They are now called biss_encoder and ssi_encoder. With the addition of the incremental_encoder driver (coming soon) this will make it clearer th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
2012-07-21 Added the quadrature encoder driver, it hasn't been tested, but it should work. I also learned that I could simplfy how I was configuring the pins in the limit switch driver, so I fixed that. I also 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
2012-07-23 Tested quadrature encoder driver, it now works. Started work on a communications driver for the amplifiers, header file is done, and have started work on the implementation. CRC generation now works 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
2012-07-23 Finished implementing the dzralte comminucation driver. Added a couple features to the uart driver.
2012-07-24 Added a ADC driver. This probably won't be the final version, since it generates way more interrupts than nessesary. But it works, so I wanted to put it in the repository.
2012-07-24 Reimplemented the ADC interrupt system so now many fewer interrupts should be generated. I also documented the ADC header file.
2012-07-24 Tested new ADC driver, and fixed some bugs. The medulla library is now complete.
2012-07-26 Added PDO entries for measured current for each amplifier
2012-07-26 In the last commit I mistakenly had two currents for the hip medulla. Fixed this and generated the sii files.
2012-07-30 More EtherCAT Progress. Intend to fork and begin switch to EtherLabs's master.
2012-08-01 We figured out that if we are using EtherLab then we need to have all pdo entries with the same index have seperate entry subindices. I fixed this problem in the ESI file and updated the SII files.
    [main.cpp, main.h]
2012-08-03 ECat testing... Why can't anybody make a working ECat master?!?!‽
2012-08-09 Finally committing the last changes to the menial, strain gauge digitizer, and encoder differential driver boards. Added schematic for body status board, PCB to come in the near future.
    [body_status_board_v1.sch, encoder_differential_driver_v1.pcb, menial_board_21.sch, strain_gauge_digitizer_v1.pcb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]
2012-08-09 More work on the body status board. Added PCB file for the board.
    [body_status_board_v1.pcb, body_status_board_v1.sch]
2012-08-16 Added incremental encoder pdo entries to leg medulla ESI file.
2012-08-16 Committing some work to the body status board.
    [body_status_board_v1.pcb, body_status_board_v1.sch, encoder_differential_driver_v1.sch]
2012-08-16 Fixed the medulla leg esi file finally.
2012-08-20 Removing drl-sim from trunk.
    [all_in_one.urdf.xacro, atrias.urdf.xacro, atrias20_biped_boom_header.urdf.xacro, atrias20_biped_planar_header.urdf.xacro, atrias20_boom_header.urdf.xacro, atrias20_leg.urdf.xacro, atrias20_planar_header.urdf.xacro, atrias20_torso.urdf.xacro]
2012-08-21 Give connectors a way to report events.
2012-08-21 Working on the body status board again. I have the logic circuit for the comptuter LEDs drawn up. I think I have also finalized the location of the large switches and buttons.
    [body_status_board_v1.pcb, body_status_board_v1.sch]
2012-08-21 Corrected template naming scheme
    [controller_component.cpp, controller_gui.cpp]
2012-08-21 Beginning the sim connector.
2012-08-21 Refactoring sim connector.
2012-08-21 Put RT Ops at priority 80 and some more work on the simulation connector.
2012-08-21 Make new sim connector work!
2012-08-21 Finished initial routing of body status board.
    [body_status_board_v1.pcb, body_status_board_v1.sch]
2012-08-21 Add save parameters button to glade file.
2012-08-21 Fork rosparam so the GUI doesn't die!
    [atrias_gui.cpp]
2012-08-21 Fixes to the DC/DC power supply board. - Moved one of the bulk capacitors to the output of the comptuer power supply. - Removed one of the unneeded logic power connectors and changed one to a minifit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
    [ATRIAS_PowerSupply.brd, ATRIAS_PowerSupply.sch]
2012-08-22 Partially fix a quirk where GUI tries to load parameters before rosparam has finished running.
    [atrias_gui.cpp]
2012-08-23 Almost done on controller manager overhaul, setting xenomai watchdog timer back to 4 seconds
2012-08-23 Tracked down an annoying bug in controller-generation
    [controller_component.cpp]
2012-08-23 Remove missed deadline checks from RT Ops. This was causing spamming when the simulation is run. This check is now the responsibility of the Connectors.
2012-08-23 The Noop connector now reports missed deadlines.
2012-08-23 Fixing some things in the atc_component template
    [controller_component.cpp]
2012-08-23 Creating a new velocity tuning top level controller.
2012-08-24 Fianlizing body status board.
    [body_status_board_v1.pcb]
2012-08-24 A few more slight changes before switching work over to the EtherCAT Connector.
2012-08-24 Beginning work on EtherCAT connector.
2012-08-24 Some more renaming for the ECat Connector.
2012-08-24 More work on the new ECat Connector
2012-08-24 More work on the ECat connector.
2012-08-24 Finishing all functionality in ECat Connector except for the Medulla drivers.
    Still needs to be tested...
2012-08-24 Debugging the EtherCAT master. Having timing issues ☹
2012-08-25 Well, the new ECat connector runs. It's buggy though.
2012-08-27 Turns out that EtherLabs causes a switch to secondary mode in Xenomai. Test complete.
2012-08-27 Finished layout and rounting of body status board.
    [body_status_board_v1.pcb]
2012-08-27 Fixing gains and current position setting on motor position controller
    [controller_component.cpp, controller_gui.cpp]
2012-08-27 Fix torque controller.
2012-08-27 More fixes to the body status board. This should be the final version.
    [body_status_board_v1.pcb]
2012-08-28 Correcting controllers to work with the new system
    [controller_component.cpp]
2012-08-28 Updated controller template to zero torques when disabled
2012-08-28 Made new launch files for the control system and removed debug printf's for controller manager
2012-08-28 Fixing a bug in the controller manager that prevents a new controller from loading when switching from an active controller to a different one
    [atrias_gui.cpp]
2012-08-29 Added BOM for body status board
    [body_status_board_bom.csv]
2012-08-29 I just realized that for some reason the new version of the menial board was never getting committed. This is finally committing it.
    [menial_board_21.pcb]
2012-08-30 More SOEM and EtherLabs testing. Time to start on an EtherLabs connector.
2012-08-30 Beginning work on the EtherLabs connector.
    :(
2012-08-30 Renaming stuff in the EtherLabs connector. Time to code!
2012-08-30 Converted ECatConn class to ELabsConn in the EtherLab connector.
2012-08-30 More work on the EtherLabs connector. Will restart and do more quickly (since we'll switch back to SOEM soon anyway).
2012-08-30 Beginning another rewrite of the EtherLabs connector.
2012-08-30 Added correct sizes for medulla sync managers.
    [robot_invariant_defs.h]
2012-08-30 Updating calibration values for leg #1
2012-08-30 We should be ready to try compiling the new EtherLabs connector.
2012-08-31 Renabled the limit switches and made some changes to help debug the medulla hanging issue. Which has now been fixed.
    [medulla.c, medulla_leg.c, medulla_leg.h]
2012-08-31 More EtherLabs connector work. We need at least *something* to work...
2012-08-31 Fix alignment in robot_invariant_defs.
    [robot_invariant_defs.h]
2012-08-31 Making the medulla code ignore bad encoder values. Needs to be tested.
2012-08-31 Fix sign error on leg A motor minimum location
    [robot_invariant_defs.h]
2012-09-01 Added safety regions around motor limits in firmware.
2012-09-03 Commit tabletop changes (broken!).
    [LegMedulla.cpp, controller_component.cpp]
2012-09-03 Firmware now ignores invalid position spikes when checking for motor out of range errors.
    [medulla_leg.c]
2012-09-03 Add motorVelocity field to robot_state_hip.msg.
2012-09-04 Updated ESC files again
    - Added knee force PDO entries to the leg medulla tx PDOs.
    - Regenerated the SII files from the ESI file.
2012-09-04 Updated medulla firmware to use new ESI files.
    - Added the medulla cycle couter PDO entries to the hip and boom
    devices. Because for some reason, they weren't already in there.
    - Added defines to invariant_defs for the number of PDO entries each
    type of medulla has. This is mostly for the firmware, but it might be
    useful for the master as well.
    - Updated firmware for all medullas to use these and the sync manager
    length defines, instead of hard coded magic numbers.
    - Moved the medulla cycle counter handler into the top level medulla.c
    file and out of the medulla_leg file.
    - Added support of the medulla cycle counter into the hip and boom
    medulla firmware.
2012-09-04 Updated medulla firmware to use new ESI files.
    - IMU documentation adde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
2012-09-04 Added force sensor PDOs to leg medulla firmware.
2012-09-05 Beginning work on Boom Medulla drivers...
2012-09-05 Let's make the EtherCAT connector build correctly...
2012-09-05 The Boom Medulla should now be able to properly read out pitch data.
    Pitch rate and all other functionality, however, is still in the works.
2012-09-05 The Boom Medulla driver now correctly reads the body pitch angle.
    The other encoders and the body pitch velocity aren't read, however.
    [BoomMedulla.cpp]
2012-09-06 Fixed bug in leg medulla firmware that kept it from compiling.
    [medulla_leg.c]
2012-09-06 Some more work on the Boom Medulla code.
    I will now switch to working on the Orocos Timer freezing bug.
    [BoomMedulla.cpp]
2012-09-06 Switch over the EtherCAT Connector's timing to using clock_nanosleep rather than a RTT::os::Timer.
    Closes issue 107
    [robot_invariant_defs.h]
2012-09-06 Body pitch velocity is now calculated in the Boom Medulla code.
    Needs testing.
2012-09-06 Added pinout datasheet for IMU. Includes connector information
2012-09-06 Commented out the matlab controller printf
2012-09-06 Corrected biped hip motor values
    [atrias20_biped.cpp]
2012-09-07 Updates to robot definitions.
    - Fixed misspelling in robot_invariant_defs.h. (Fixes issue 106)
    - Changed how the leg calibration values are defined. The calibration
    values for each individual leg are defined in their own header file.
    Then the headers for the legs uses are then then included into the
    robot_variant_defs file. This system isn't as clean as I would like it
    to be yet, but it works for now.
    - Added calibration values for leg #2.
    [leg1_definitions.h, leg2_definitions.h, medulla_hip.c, medulla_leg.c, robot_invariant_defs.h]
2012-09-07 Add X encoder decoding to the Boom Medulla code.
2012-09-07 The simulated hip positions and velocities are correct now.
    [atrias20_biped.cpp]
2012-09-07 simulink sin wave torque controller ready for testing
2012-09-07 The Boom Medulla driver should now be complete. Needs testing.
    New issue
    Summary: Move boom-related variant definitions into a separate file
    Status: Accepted
    Labels: Priority-Low
    The leg-related variant defs have already been split out. So should the boom-specific defs.
    New issue
    Summary: Rename PITCH_ENCODER_RAD_PER_TICK to BOOM_PITCH_ENCODER_RAD_PER_TICK
    Status: Accepted
    Labels: Priority-Low
    We should have all boom-related variant defs prefixed with "BOOM_".
    Update issue 89
    The Boom Medulla driver should now be complete, although it's mostly untested.
    Update issue 104
    The Boom Medulla copies over its error flags.
    [BoomMedulla.cpp, robot_invariant_defs.h]
2012-09-07 medulla_hip now has basic IMU code within, is probably going break something and will be incomplete
2012-09-07 More work on the hip driver.
    I am now waiting on Kit's changes to the PDOs before I implement the rest.
2012-09-07 Modified imu implementaion in medulla hip to copy data to ethercat, still probably broken
    [medulla_hip.c]
2012-09-07 Added IMU and incremental encoder PDOs to hip medulla ESI file.
2012-09-10 The EtherCAT connector now reports what the robot's configuration is.
2012-09-10 Fixed GUI so that it draws both legs. Fixed the directions of the leg2 definitions. Some other things, not sure what they are.
    [LegMedulla.cpp, atrias_gui.cpp, leg2_definitions.h, robot_invariant_defs.h]
2012-09-10 Added safety code to leg medulla firmware.
    The old firmware only implemented safeties for leg A medullas. This
    fixes that problem.
    [medulla_leg.c]
2012-09-10 Set gains and max current in the simulink controller
2012-09-10 Corrected the leg motor torque constants and made friction obvious if it is ever enabled in gazebo
    [atrias20_biped.cpp, atrias20_leg.cpp]
2012-09-10 Modify motor torque GUI for biped.
2012-09-11 The Hip Medulla driver is done except for encoder reading.
    I'm waiting until someone who knows what the values in robot_state_hip mean until I resume.
2012-09-11 Documents created when ordering the Emoteq MF0150 and QB 023 Motors for ATRIAS 2.1 Bipeds
2012-09-11 Fixing the simulink controller build script
    [controller_component.cpp]
2012-09-11 Finished Hip driver!
    Closes issue 89
    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
    [HipMedulla.cpp, robot_invariant_defs.h]
2012-09-11 Make the Leg Medulla code process error flags.
    Closes issue 104
    [LegMedulla.cpp]
2012-09-11 The EtherCAT connector now reports missed deadlines.
    Closes issue 85
2012-09-11 Adding in debug code to Leg Medulla to help debug issue 83.
    Updates issue 83
    I have now added in code to LegMedulla.h (lines 67-70) to help debug this issue.
    [LegMedulla.cpp]
2012-09-11 Beginning Medulla Drivers package.
2012-09-11 Fixed hip medulla code
    Integrated IMU code a little better. Disabled the debug port when the
    code is running on a right hip medulla (which is the one connected to
    the IMU).
    [medulla.c, medulla_hip.c, medulla_hip.h]
2012-09-11 Moving over medulla driver files.
2012-09-11 Orocos-ifying the Medulla Drivers package.
2012-09-11 Making an actual Orocos library now w/ the drivers.
2012-09-11 Added wiring color sheet to documentation section
2012-09-11 Changing namespace name on medulla drivers.
2012-09-11 The EtherCAT connector now uses the new libraries.
2012-09-11 I have now converted the Medulla drivers over to a common interface.
    Closes issue 102
    [BoomMedulla.cpp, HipMedulla.cpp, LegMedulla.cpp, Medulla.cpp]
2012-09-12 My previous work on standardizing the interface was flawed... this fixes the Boom medulla code.
    Now that the framework's been laid, I'll do the same for the hip and Leg medullas.
    [BoomMedulla.cpp]
2012-09-12 Now the Leg Medulla uses the new interface!
2012-09-12 atc_leg_sin_wave updated for two legs
2012-09-12 Fork roslaunch and rosnode calls so script doesn't hang.
    [log_data.py]
2012-09-13 Fixing the leg medulla... stupid PDO entry ordering.
    [LegMedulla.cpp]
2012-09-13 Changed the motor current scaling factor for a sigle amplifier.
2012-09-13 Fixing hip estop detection and make the sim report the robot configuration.
    [atrias20_biped.cpp, atrias20_leg.cpp]
2012-09-13 Fix a stupid mistake (how did I not get compiler warnings?!?!‽‽)
2012-09-13 Adding in new limit switch fields and clamping limit switch values.
2012-09-13 Add in spring deflection reset on startup.
    [LegMedulla.cpp, robot_invariant_defs.h]
2012-09-13 Updated wire color chart to include Hip Encoders and IMU wires
2012-09-13 Corrected an include error
    [controller_component.cpp]
2012-09-13 Update motor position GUI for biped.
2012-09-13 Correct hscale to spinbutton.
    [controller_gui.cpp]
2012-09-14 atc_motor_position controller now functional for the biped. Also fixed a bug in the simulation.
    [atrias20_biped.cpp, controller_component.cpp, controller_gui.cpp]
2012-09-14 Fixed firmware bugs
    - Fixed bug where all limit switches on right leg were disabled.
    - Added debouncing to limit switches.
    - Fixed some bugs with the IMU code integration in hip medulla.
    [medulla_hip.c, medulla_leg.c, robot_invariant_defs.h]
2012-09-14 Make the EtherCAT connector print out on a missed deadline. May break RT in case of missed deadlines, but we need to know if we have ANY at ALL!
2012-09-14 Modified medulla leg and amplifier code to toggle portc pin 5 when pwm updates, should add debug ifdefs or remove after testing
2012-09-14 Reset GUI when motor selection changes.
    [controller_gui.cpp]
2012-09-15 Fixed the hip medulla ethercat issues by removing the IMU PDO entries..... Not sure why we needed to do this.
    [medulla_hip.c, medulla_hip.h, robot_invariant_defs.h]
2012-09-15 Debugging the Medulla drivers. Just the Boom to go!
2012-09-15 Correcting atc_motor_torque_sin gui range
    [controller_gui.cpp]
2012-09-16 Adding hip controls to leg sine controller gui
2012-09-17 Debugging a small error in the atc_leg_sin_wave/asc_path_generator controllers
    [controller_component.cpp]
2012-09-17 Added knee force sensor to leg medulla code.
2012-09-17 Calibrated boom pitch encoder.
2012-09-17 Changed sub controllers to run in client thread instead of own thread. Running in own thread was cauing mode switches for some reason.
2012-09-17 Changed all of the controllers to use the client thread, and removed individual priority setting
2012-09-17 Fixing the sim test controller...
    I thought I did this before? Twice?!?‽
    [controller_component.cpp]
2012-09-18 Adding spin buttons to gui.
2012-09-18 Putting in current caps
2012-09-18 Fixed bug with status LED in medulla.c
    Fixed a bug in medulla.c which caused the medulla to initilize the LEDs
    and turn on the green LED on bootup even if the ENABLE_LEDS define was
    not enabled.
    [medulla.c]
2012-09-18 Removed software leg length extension e-stop
2012-09-18 Adding IMU PDOs back in
2012-09-19 Added support support leg switching to gui.
2012-09-19 Added default support leg.
2012-09-20 New fast leg swing controller... we're finally moving!
2012-09-20 reverting the ESI file, cause I screwed it up.
2012-09-21 Minor fixes to atc_umich_2
    [controller_gui.cpp]
2012-09-21 Calculate desired velocity.
2012-09-21 Add range of motion demo controller.
    This code is untested, and it probably won't build.
    [controller_component.cpp, controller_gui.cpp]
2012-09-21 Put in fake hip motor limits.
2012-09-21 The fast leg swing controller now swings the left leg and holds the right one stationary.
2012-09-21 The fast leg swing controller now moves all axes.
2012-09-21 Leg swing controller internals seem to be complete. I still need a GUI, however.
2012-09-21 Implement fast leg swing demo GUI.
2012-09-21 Implement GUI code for fast leg swing demo controller.
2012-09-21 Make sim connector periodic.
    This enables the connector to keep up with the sim. EventPorts are apparently not fast enough.
2012-09-22 Correct misspelled field names.
    [controller_gui.cpp]
2012-09-22 Check that all motions have completed when switching to manual mode.
    Otherwise, motors can collide as one motor is finishing a motion while another is moving in the opposite direction per GUI commands.
    [controller_component.cpp]
2012-09-22 More work on the fast motion controller, and re-calibrating leg 3
2012-09-22 Incorporating GUI into fast leg swing controller code. Need to determine suitable defaults.
2012-09-22 Fixing parabola velocity calculations.
2012-09-22 Fixing bug in right leg A velocity decoding.
    [LegMedulla.cpp]
2012-09-24 Finishing fast leg swing controller. Needs testing.
2012-09-24 Added sin wave reset code
    [controller_component.cpp]
2012-09-24 Disable hasParam check to prevent hang.
    [atrias_gui.cpp]
2012-09-24 Fixing things in atc_demo_range_of_motion
    [controller_component.cpp]
2012-09-24 Fixing the range of motion order
    [controller_component.cpp]
2012-09-24 Enable right leg for range of motion demo.
2012-09-25 Switching hip motor phases back to Ryan's.
2012-09-25 Change to using different leg definitions for second biped.
2012-09-25 Enter calibration values for leg 4.
2012-09-25 Enter hip calibration values.
2012-09-26 Add sane limits to leg and hip amplitudes.
2012-09-26 Enter new calibration values for biped #1.
2012-09-27 Enter calibration values.
2012-09-27 Move motor torque scaling factors and limits to variant defs.
    Also set max motor torque for biped 2 to 120 amps.
2012-09-27 Implement smooth initialization for fast leg swing demo controller.
2012-09-27 Fixing the build of RT Ops after moving torque limits into robot_variant_defs.h
2012-09-28 Switching biped2 to single amplifier scaling values. Fixing RT Ops so that it compiles with the moved current declarations.
    [biped2_variant_defs.h]
2012-09-28 Biped 2 is now on 1 amp per motor.
2012-09-29 Make smooth start/stop of fast leg demo controller work.
2012-09-29 Fix incorrect field names.
    [controller_gui.cpp]
2012-09-29 Fix setParameters() in fast leg demo controller.
    [controller_gui.cpp]
2012-10-11 Reduced minimum leg length to a more reasonable value.
2012-10-11 Recalibrated the hip encoder
2012-10-11 Modifications to fast leg swing demo from New York. I don't remember what all was changed.
2012-10-15 The rest of the changes for correcting subcontrollers
    [controller_component.cpp]
2012-10-16 com to leg transforms filled out with proper equations
2012-10-18 The start and stop scripts won't segfault anymore, because orocos functions have been removed
    [controller_component.cpp]
2012-10-19 Beginning motor test controller.
2012-10-19 The motor test controller now produces random torques, but still needs to produce random durations.
2012-10-19 Seems like the motor test controller's done.
2012-10-19 Adding a minimum absolute torque to the motor test controller.
2012-10-19 changed max current for motor_test to 1A
2012-10-19 - changed timing for motor_test
2012-10-19 - changed current boundaries for motor_test
2012-10-24 The rotorAngle and rotorVelocity values are now comparable to the motorAngle and motorVelocity values
    This means we can measure harmonic drive deflection.
2012-10-24 Actually starting the velocity tuning controller.
2012-10-24 Cleaning up the beginnings of the velocity test controller.
2012-10-24 More work on the velocity tuning controller.
2012-10-26 The velocity tuning controller now compiles -- ready for tuning.
2012-10-26 Basic functioning of the velocity tuning controller complete. Needs better defaults.
2012-10-30 The left and right legs on biped 1 has been switched, Changing definitions file to reflect this.
2012-10-30 Make buttons work.
2012-10-31 Updated leg calibration values
2012-10-31 Updated calibration values for biped 1
2012-10-31 Calibrated hip encoder
2012-11-02 Correct incorrect C syntax stuff.
    [controller_component.cpp]
2012-11-06 Fixing velocity tuning controller, more eq_point work.
    [controller_component.cpp]
2012-11-06 bug fixes for eq_point
    [controller_component.cpp]
2012-11-08 There's still issues w/ which PD controllers are which, but the hip controllers' gains are now set.
    [controller_component.cpp]
2012-11-08 Fixing hip control in eq_point TLC.
    [controller_component.cpp]
2012-11-09 change flight leg calculation for swing leg in eq_point_control
2012-11-10 Minor fix to linear interpolation controller. Otherwise, it's done!
    [controller_component.cpp]
2012-11-13 The velocity tuning controller has been updated to support more relay modes for benchtop testing.
2012-11-13 Fix radio buttons on atc_velocity_tuning
    [controller_gui.cpp]
2012-11-14 Adding a sudoers file for roslaunch and fixing the incremental encoder decoding.
    [LegMedulla.cpp]
2012-11-15 Started new directory for body status board v1.1
    [body_status_board_bom.csv, body_status_board_v1.pcb, body_status_board_v1.sch, body_status_board_v1_1.pcb, body_status_board_v1_1.sch]
2012-11-15 Finishing up the spring torque subcontroller.
    Will now test.
2012-11-15 Switched LEDs on body status board for ones that work with the medullas.
    [body_status_board_bom.csv, body_status_board_v1.pcb, body_status_board_v1.sch, body_status_board_v1_1.sch]
2012-11-17 Created PDFs of board schematics.
    [amp_breakout_v1.sch, body_status_board_v1_1.pcb, body_status_board_v1_1.sch, encoder_differential_driver_v1.sch, menial_board_21.sch]
2012-11-20 Finished revisions to body status board. It's now ready to order.
    [body_status_board_v1_1.pcb, body_status_board_v1_1.sch]
2012-11-20 Part values were not put on bottom layer silkscreen.
2012-11-20 Added board description to bottom silk screen.
2012-11-21 Created CAM files and bill of materials for body status board version 1.1
    [BillOfMaterials.csv, body_status_board_v1_1.pcb, body_status_board_v1_1.sch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]
2012-11-27 another bugfix for atc_eq_point
    [controller_component.cpp]
2012-11-29 modified swing leg control atc_eq_point
2012-11-30 Added medulla uart test.
2012-11-30 Added testing code for SSI encoder ports on menial board.
2012-11-30 Added limit switch test.
2012-11-30 Added test for amplifier debugging uart.
2012-11-30 Added medulla ADC test.
2012-11-30 Added incremental encoder test program.
2012-11-30 Added test for USART ADC.
2012-12-01 Updating boom height and Z encoder calibration.
2012-12-01 Adding more framework to asc_spring_torque.
2012-12-01 Beginning python data processing script for spring torque controller.
2012-12-01 Adding in the preliminary spring test data.
2012-12-02 More spring torque asc work.
2012-12-02 Spring tester data parsing script almost done... just need to make it write to file now.
2012-12-07 Calibrating boom Z axis... a new pitch calibration value's been entered, but it isn't completely accurate (we need to either be able to measure the robot's angle or level it out to get an accurate ca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
2012-12-07 Added PWM test program.
2012-12-10 Adding some more jitter/latency checks -- now logs DC timestamps.
    Also, I'm beginning to add vim modelines w/ peoples' personal favorite
    settings to each of the files so stuff works.
2012-12-10 Fixed make file for pwm test and removed files that shouldn't have been committed
2012-12-11 And fixing asc_spring_torque to match that last change...
    [controller_component.cpp]
2012-12-11 Fixed bug in medulla_leg where the wrong PDO entries count was passed to the ethercat library. This caused problems in GCC 4.7
    [medulla_leg.c]
2012-12-11 The Subcontroller test controller is now a complete example of the new subcontroller loading system.
    Also, I fixed a bug in ComponentLoader.cpp
    [controller_component.cpp]
2012-12-12 Added definitions file for biped 3 and the 5th leg.
    Also removed the NUM_MEDULLAS_ON_ROBOT define from all biped definitions. This was only being used in the definition for an unimplemented and unused function in the controller manager.
2012-12-12 atc_force_hopping now has a GUI
    (It's kinda ugly -- this most likely won't change).
    [controller_component.cpp, controller_gui.cpp]
2012-12-12 Calibrated absolute encoders on leg 5
2012-12-13 Some much-needed refactoring.
    Hopefully this won't break stuff. I'd test out the EtherCAT connector, but the power supply is in use for the benchtop test, so I can't do so very easily. I'll be here in the morning to test.
    Closes issue 97
    [LegMedulla.cpp, Medulla.cpp]
2012-12-13 Commenting out a printf in atc_eq_point
2012-12-13 More atc_force_hopping work. Adding code for different states.
    The GUI now reflects the current state, too.
2012-12-13 Enabled limit switch interrupts. This increases responce time to limit switches being pressed from 50mS to 3.8mS.
2012-12-13 atc_force_hopping is almost ready to go... just need to implement gain switching.
2012-12-14 atc_force_hopping bugfixes.
    More to come.
    [controller_component.cpp]
2012-12-14 Another fix to atc_force_hopping
    [controller_component.cpp]
2012-12-14 Boom height correction for the rubber mats and changing over atc_force_hopping to use toe height.
    [biped2_variant_defs.h, controller_component.cpp]
2012-12-14 Adding an Encoder class to the medulla drivers.
    This should clean up the drivers somewhat, even if I do it piece-by-piece.
2012-12-14 The encoder class has been added.
    Just need to debug now.
2012-12-15 Make this work on the right leg, and add an estop for safety.
2012-12-16 Fixed issue #127. Fixed a bug that possibly caused issue #155.
    [atrias_gui.cpp]
2012-12-17 Adding strain gauge processing, and a fix to the controller manager.
    This is probably not entirely correct -- Michael, can you check it out? I'm probably running the Event Manager loop extraneously.
    [LegMedulla.cpp, robot_invariant_defs.h]
2012-12-17 Let's make the boom data more accurate, and fix switch encoders on lLegB
    [biped1_variant_defs.h, leg1_definitions.h]
2012-12-18 Removing a long-deprecated value from robot_state_hip.
    I've also fixed atc_demo_range_of_motion so it compiles -- how did it ever work?
    [controller_component.cpp]
2012-12-19 Started adding safety damping code.
    Modified all medulla firmwares to not immediately send an estop upon
    entering error damping. Added damping controller to leg medulla.
    [medulla_boom.c, medulla_hip.c, medulla_leg.c, medulla_leg.h]
2012-12-19 Added code for detecting error damping condition.
    [medulla_leg.c, medulla_leg.h]
2012-12-19 Finished and tested error damping code in leg medulla.
    [medulla_leg.c, robot_invariant_defs.h]
2012-12-20 Removing halt detection printfs.
2012-12-20 A minor fix to atc_force_hopping.
    [controller_component.cpp]
2012-12-20 Add advanced safeties to RT Ops.
    We still need to set the min and max leg angle difference values and test this.
2012-12-21 Beginning bagfile timestamp fixing script.
    [fix_bag.py]
2012-12-22 The fix_bag script is now complete.
    Now we just need to add timestamps to our message types.
    [fix_bag.py]
2012-12-27 The Medulla drivers now ignore duplicate values from the Renishaw encoders.
    Duplicative values are usually bad reads -- if not, then it's moving extremely slowly anyway and
    ignoring one value isn't that bad anyway.
2012-12-27 Here's a fix for the pd controller's header timestamps.
    This ASC must have the deployer as a peer!
    [controller_component.cpp]
2012-12-27 Oops, the atc_force_hopping controller would've applied 2x the necessary force.
    This fixes that.
    [controller_component.cpp]
2012-12-28 Critical fix to atc_hip_force_test's gui
    [controller_gui.cpp]
2012-12-28 Removing needless cycle on ECat Connector startup.
    Closes issue 90:
    Turns out this frame isn't necessary.
2013-01-02 For now, let's ignore the toe sensor for hip force control.
    We don't want anything unexpected to happen.
2013-01-03 Changing the noop connector's priority so we can test HRT under RT_PREEMPT w/out EtherCAT.
2013-01-04 ATC_hip_force_test now correctly does gravity compensation, and is ready to test toe sensor decoding.
    [controller_component.cpp]
2013-01-04 Increased size of medulla error flags.
    [medulla_boom.c, medulla_hip.c, medulla_leg.c, robot_invariant_defs.h]
2013-01-04 Modified medulla firmware to report master watchdog error.
    [medulla.c, medulla.h, medulla_boom.c, medulla_boom.h, medulla_hip.c, medulla_hip.h, medulla_leg.c, medulla_leg.h]
2013-01-04 Making the medulla drivers and robot state compatible with the wider error flags.
    [BoomMedulla.cpp, HipMedulla.cpp, LegMedulla.cpp]
2013-04-10 Wrote RT Check class. Needs testing.
    Eventually, this should be modified to use RT Ops's RT printing operation, but since that's not implemented yet, that will have to wait.
2013-04-10 Remove the noop connector -- it'll be replaced by the csim connector.
2013-04-11 Reworking CSimConn a bit.
    It still needs more work though, but that will wait until RT Ops has been started.
    [CSimConn.cpp]
2013-04-15 We now have a realtime printing service!
    Currently, it only prints strings, but double and int support will be similar.
2013-04-17 The RT Printer can now print ints.
2013-04-18 Fixing RT printer. You now need an additional function call to end a line you're printing.
2013-04-29 RtCheck has now been modified to work with the new event metadata.
    It now sends a MISSED_DEADLINE event instead of directly printing out the error.
2013-05-07 We now cyclically send data to the GUI. Also, the missed deadline display has been updated.
    For some reason, we missed a deadline writing the log data. I should investigate -- in particular, the Header in that message is suspect, since it contains a string.
    [robot_invariant_defs.h]
2013-05-14 Working on fixes for RT_PREEMPT
    [ATC.hpp, CSimConn.cpp]
2014-02-03 Created branch "ball_screw_tester"
2014-02-12 Implemented the ballscrew Medulla source and added the necesarry changes to the Makefile, ethercat xml, and robot definitions.
2014-03-03 New ballscrew ethercat bin file compiled from edited XML file
2014-03-13 ROS configured to communicate with new Ballscrew Medulla
2014-03-30 Adding my attempt at a merged imu firmware, I don't think this code actually works.
2014-07-31 Enabled thermistors and set debug level high
2014-08-05 Working benchtop leg firmware
2015-04-05 PADS files added for Elmo EStop board, Vicor input and output boards, XBee EStop board, and updated Strain Gauge board.
    [Vicor_IAM.pcb, Vicor_IAM.sch, Vicor_LC_Filter.pcb, Vicor_LC_Filter.sch, elmo_gold_drum_port_c_v1.pcb, elmo_gold_drum_port_c_v1.sch, flat_flex_sensors.pcb, medulla_flat_flex.pcb]
2015-05-04 Leg Medulla limit switches disabled
2015-05-14 Thermistor values pushed to Simulink in ADC format
2015-05-14 Limit switch reporting disabled
2015-05-14 Thermistor PDO updates moved from check_error to update_inputs
2015-05-15 Max value clamping removed
2015-05-20 IMU Medulla error flags shifted left by one to avoid confusion with estop flag.
    [medulla_imu.h]
